thomaswach7/KOP/Teil_B/Frage_01_Rillenkugellager_2Z.md

# Projekt Fliehkraftkupplung – Teil B, Frage 1

> **Aufgabe:** Die Rillenkugellagerbezeichnung beinhaltet das Nachsetzzeichen 2Z.
> Erklären Sie diese Angabe und begründen Sie, warum diese Lagerausführung gewählt wurde.

## 1 Bedeutung der Bezeichnung `DIN 625 – 6009 – 2Z` (Pos. 11)

| Teil der Bezeichnung | Bedeutung |
|---|---|
| **DIN 625** | Norm für einreihige Rillenkugellager |
| **6** | Lagerart: Rillenkugellager, einreihig |
| **0** | Durchmesserreihe 0 (Breitenreihe 1 wird weggelassen → Maßreihe 10, sehr leichte Baureihe) |
| **09** | Bohrungskennzahl: d = 09 · 5 = **45 mm** (gilt ab Kennzahl 04) |
| **2Z** | Nachsetzzeichen: **beidseitig je eine Deckscheibe (Z)** |

Hauptmaße 6009 (Tabellenbuch): **d = 45 mm, D = 75 mm, B = 16 mm** – passend zu den
Lagersitzen Ø45 k6 (Antriebsnabe Pos. 1) und Ø75 H7 (Abtriebsnabe Pos. 2 / Deckel Pos. 4).

**Deckscheibe „Z“:**
- dünne Scheibe aus Stahlblech, im Außenring eingepresst bzw. eingerollt
- **berührungsfrei:** Zum Innenring bleibt ein schmaler Spalt (Spaltdichtung) – es schleift nichts
- „Z“ = Deckscheibe auf **einer** Seite, **„2Z“ = Deckscheiben auf beiden Seiten**
- Das Lager wird vom Hersteller mit Fett gefüllt geliefert → **Lebensdauerschmierung**, nicht nachschmierbar

Abgrenzung: **RS / 2RS** = schleifende Dichtscheiben aus Elastomer (dichter, aber mehr Reibung,
niedrigere Grenzdrehzahl und temperaturempfindlicher).

## 2 Begründung der Lagerwahl

1. **Kein Fett auf die Reibflächen (wichtigster Grund)**
   Die Lager sitzen direkt neben dem Kupplungsraum mit den Reibbelägen (Pos. 5.2) und der
   Reibfläche des Gehäuses (Pos. 3). Austretendes Fett würde die Reibungszahl μ stark senken →
   Kupplung rutscht, das übertragbare Reibmoment M_R = μ · F_N · r_R bricht ein.
   Die Deckscheiben halten das Fett im Lager.

2. **Schutz vor Belagabrieb und Schmutz**
   Beim Anfahren (Schlupfphase) entsteht abrasiver Abrieb der Reibbeläge. Zusätzlich ist die
   Umgebung eines Betonmischers sehr staubig (Zement, Sand). Die Deckscheiben verhindern, dass
   diese Partikel in die Laufbahnen gelangen. Nach außen dichtet zusätzlich der Filzring (Pos. 12) ab.

3. **Wartungsfrei / Lebensdauerschmierung**
   Die Konstruktion hat weder Schmiernippel noch Schmierbohrungen – die Lager sind nach der Montage
   nicht mehr zugänglich. Eine Fettfüllung „auf Lebensdauer“ ist daher notwendig.
   Das ist hier auch ausreichend, weil sich Innen- und Außenring **nur während des Anlaufs**
   (Kupplung offen bzw. schlupfend) relativ zueinander drehen. Ist die Kupplung geschlossen,
   laufen Antriebsnabe und Gehäuse/Abtriebsnabe synchron → keine Relativbewegung im Lager.

4. **Berührungsfrei → geringe Reibung und Erwärmung**
   Z-Deckscheiben schleifen nicht: kein zusätzliches Reibmoment, keine Zusatzwärme, hohe
   Grenzdrehzahl (bei n = 1450 min⁻¹ unkritisch). Da beim Rutschen ohnehin Reibwärme im Gehäuse
   entsteht, sind **Stahlblech-Deckscheiben temperaturbeständiger** als Elastomer-Dichtungen (RS).

5. **Kompakt, kostengünstig, Normteil**
   Die Abdichtung ist im Lager integriert (gleiche Breite B = 16 mm wie offene Ausführung) –
   es werden keine zusätzlichen Dichtelemente im beengten Bauraum zwischen Nabe und Deckel benötigt.
   Das Lager ist ein günstiges Katalog-/Normteil.

## Kurzantwort (für das Antwortdokument)

> **2Z** bedeutet, dass das Rillenkugellager 6009 (d = 45 mm, D = 75 mm, B = 16 mm) **auf beiden
> Seiten eine berührungsfreie Deckscheibe aus Stahlblech** besitzt. Das Lager ist ab Werk mit Fett
> gefüllt und **lebensdauergeschmiert**.
> Gewählt wurde diese Ausführung, weil **kein Schmierfett auf die Reibbeläge bzw. die Reibfläche des
> Gehäuses gelangen darf** (sonst sinkt μ und die Kupplung rutscht), weil das Lager vor **Belagabrieb und
> Staub** geschützt werden muss und weil die Lager nach der Montage **nicht nachgeschmiert** werden
> können. Da sich die Lagerringe nur beim Anlauf relativ zueinander drehen, reicht die Fettfüllung für
> die gesamte Lebensdauer. Die berührungsfreie Z-Abdichtung verursacht zudem keine Zusatzreibung und
> ist unempfindlich gegen die beim Rutschen entstehende Wärme.
