thomaswach7/KOP/Portrait_CAD/vorschau_linien.png

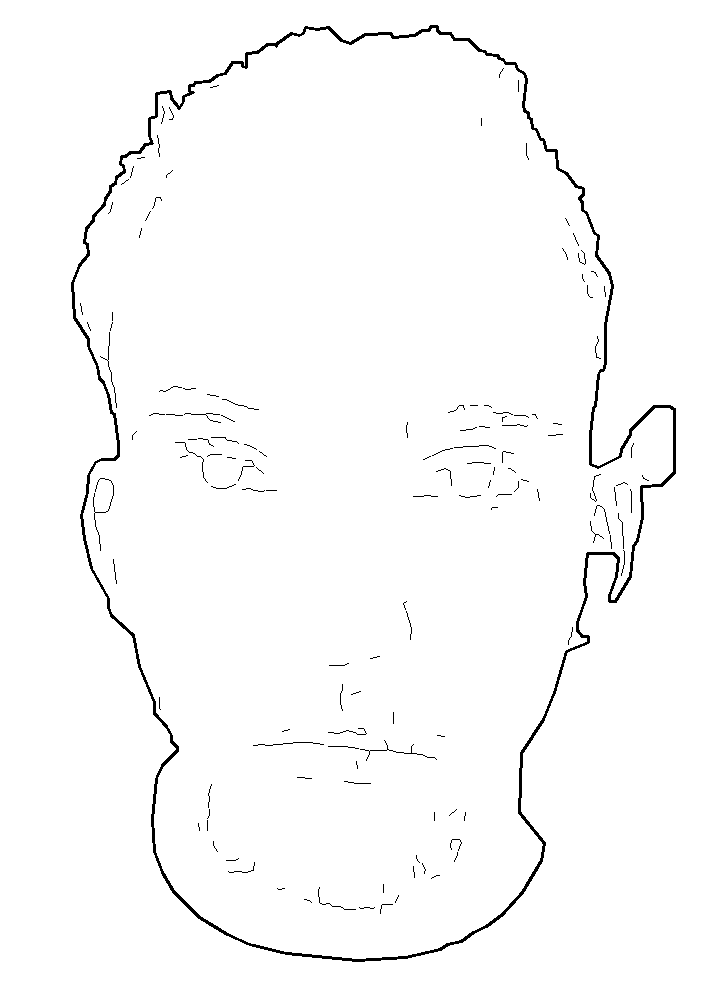
Portrait_CAD/vorschau_linien.png
