thomaswach7/KOP/Portrait_CAD/vorschau_relief.png

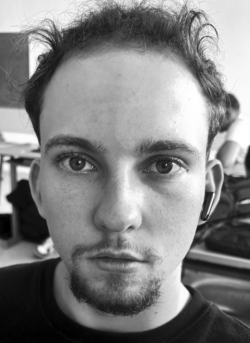
Portrait_CAD/vorschau_relief.png
