thomaswach7/KOP/Skulptur_3D/vorschau_8_ansichten.png

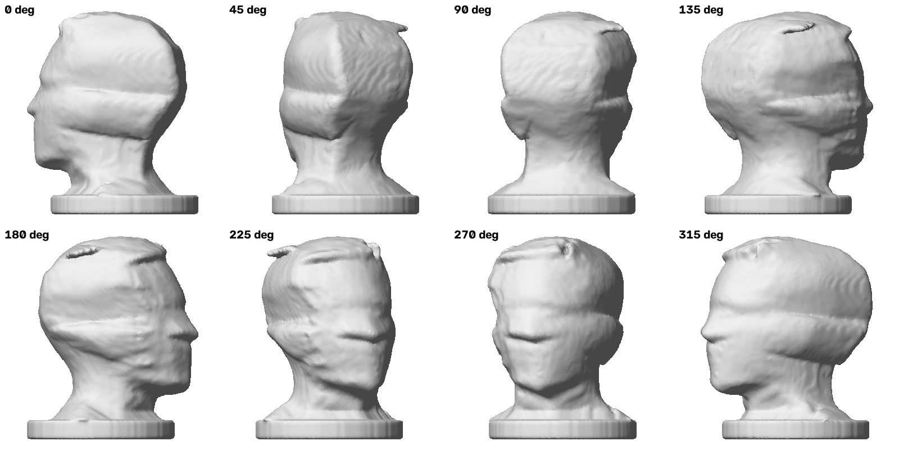
Skulptur_3D/vorschau_8_ansichten.png
