thomaswach7/KOP/Teil_A/Gesamtzeichnung_Vorschau.png

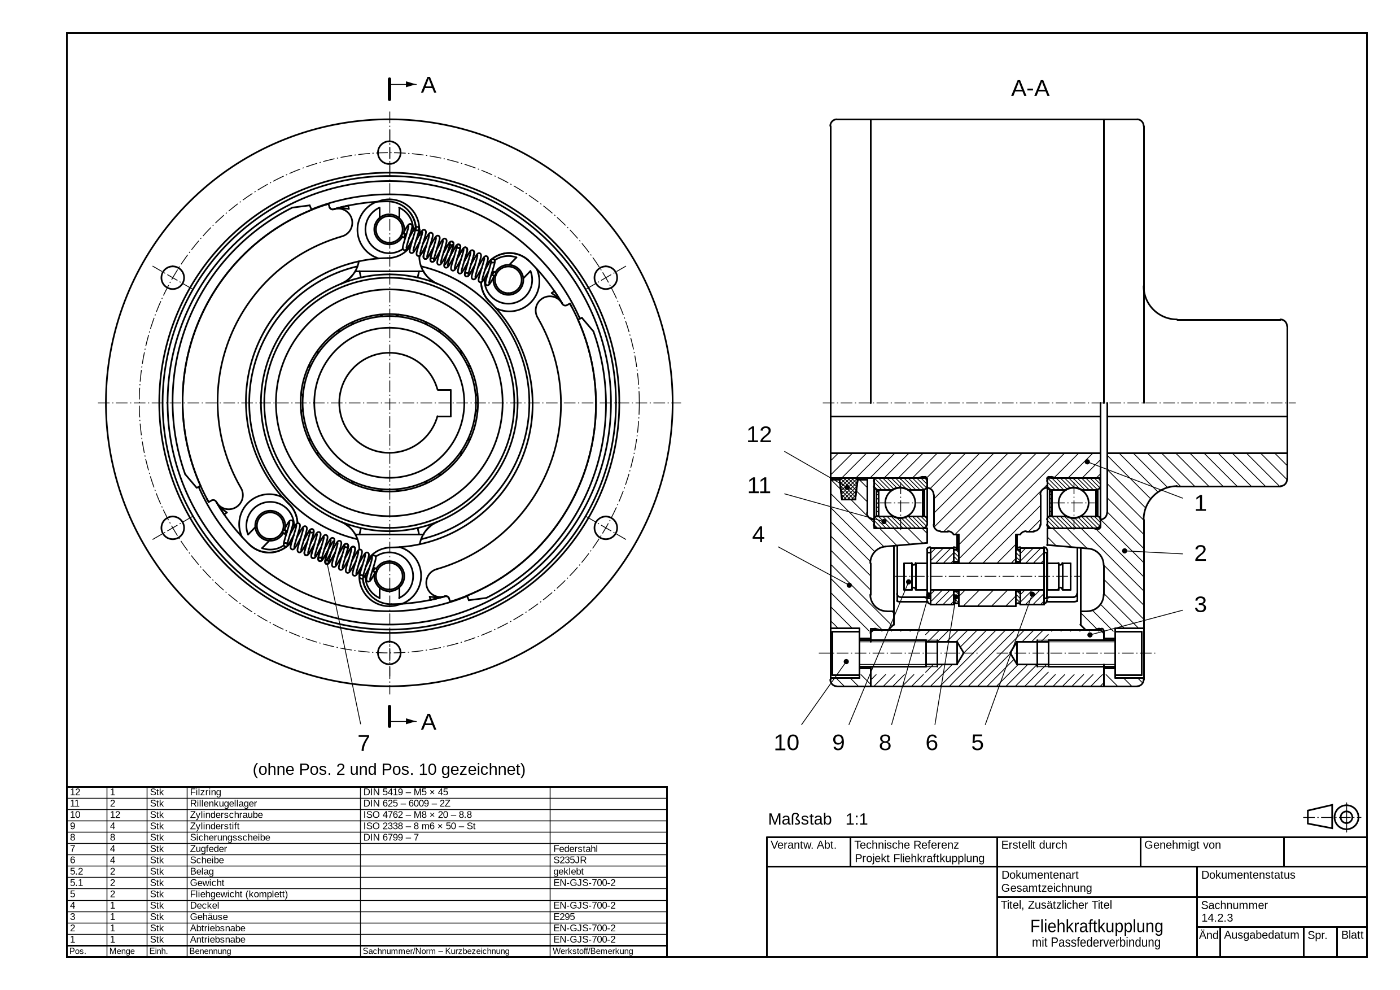
Teil_A/Gesamtzeichnung_Vorschau.png
