thomaswach7/KOP/Teil_A/CAD/Baugruppe_Fliehkraftkupplung_komplett.step

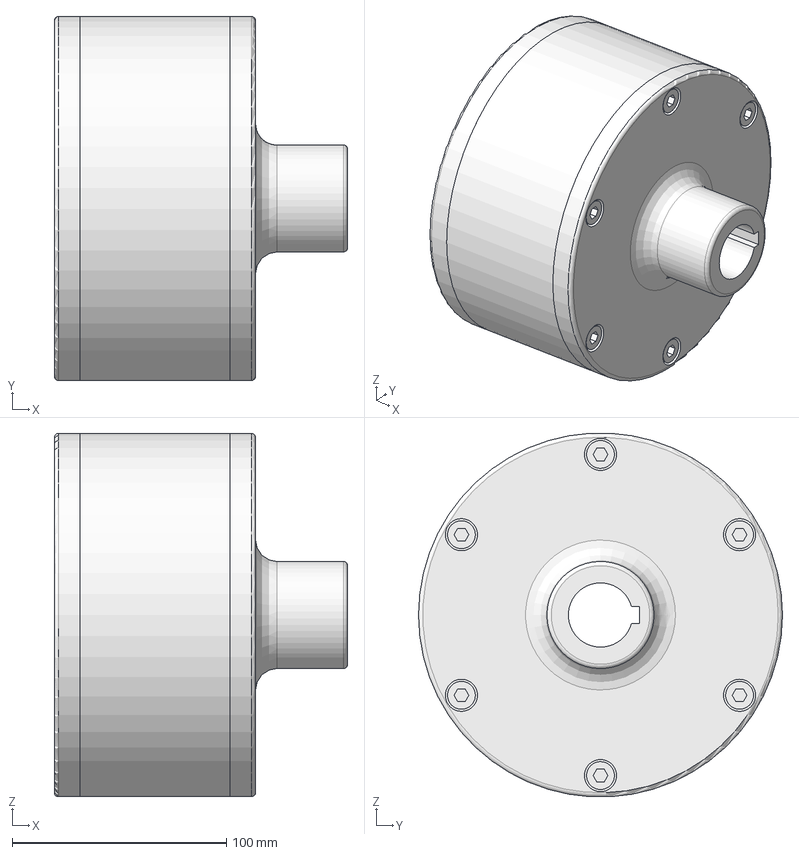
[picture p62: CAD file, 2026-10-28]
Teil_A/CAD/Baugruppe_Fliehkraftkupplung_komplett.step
137.0 x 170.0 x 169.7 mm
Pos1_Antriebsnabe
Pos2_Abtriebsnabe
Pos3_Gehaeuse
Pos4_Deckel
Pos5.1_Gewicht_1
Pos5.2_Belag_1
Pos5.1_Gewicht_2
Pos5.2_Belag_2
Pos6_Scheibe_1
Pos6_Scheibe_2
Pos6_Scheibe_3
Pos6_Scheibe_4
Pos7_Zugfeder_1
Pos7_Zugfeder_2
Pos7_Zugfeder_3
Pos7_Zugfeder_4
Pos8_Sicherungsscheibe_1
Pos8_Sicherungsscheibe_2
Pos8_Sicherungsscheibe_3
Pos8_Sicherungsscheibe_4
Pos8_Sicherungsscheibe_5
Pos8_Sicherungsscheibe_6
Pos8_Sicherungsscheibe_7
Pos8_Sicherungsscheibe_8
Pos9_Zylinderstift_1
Pos9_Zylinderstift_2
Pos9_Zylinderstift_3
Pos9_Zylinderstift_4
Pos10_Zylinderschraube_1
Pos10_Zylinderschraube_2
Pos10_Zylinderschraube_3
Pos10_Zylinderschraube_4
Pos10_Zylinderschraube_5
Pos10_Zylinderschraube_6
Pos10_Zylinderschraube_7
Pos10_Zylinderschraube_8
Pos10_Zylinderschraube_9
Pos10_Zylinderschraube_10
Pos10_Zylinderschraube_11
Pos10_Zylinderschraube_12
Pos11_Rillenkugellager_1
Pos11_Rillenkugellager_2
Pos12_Filzring
