thomaswach7/KOP/Portrait_CAD/portrait_relief.stl

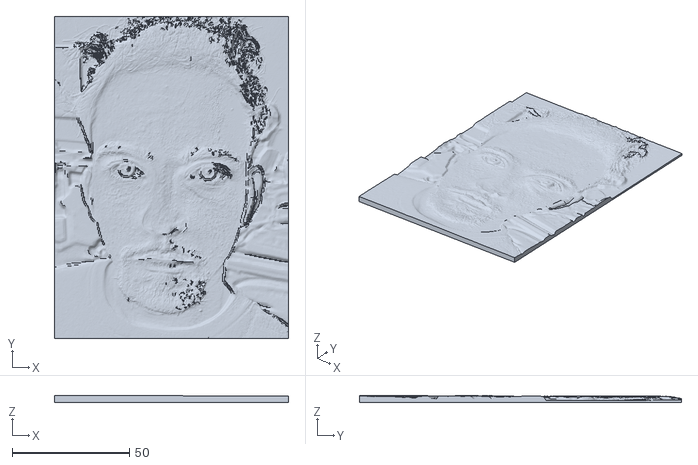
[picture p63: CAD file, 2026-10-09]
Portrait_CAD/portrait_relief.stl
100.0 x 137.6 x 3.00
