thomaswach7/KOP/Skulptur_3D/kopf_skulptur.stl

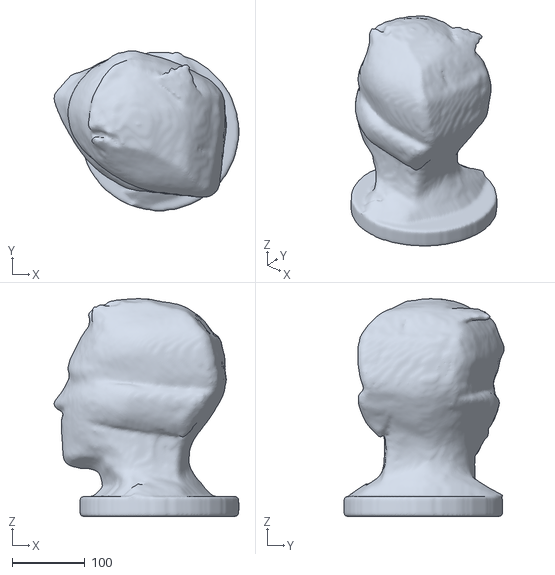
[picture p64: CAD file, 2026-10-09]
Skulptur_3D/kopf_skulptur.stl
253.5 x 219.9 x 299.4
