thomaswach7/KOP/Teil_A/CAD/Einzelteile_alle/Pos11_Rillenkugellager_6009-2Z.stp

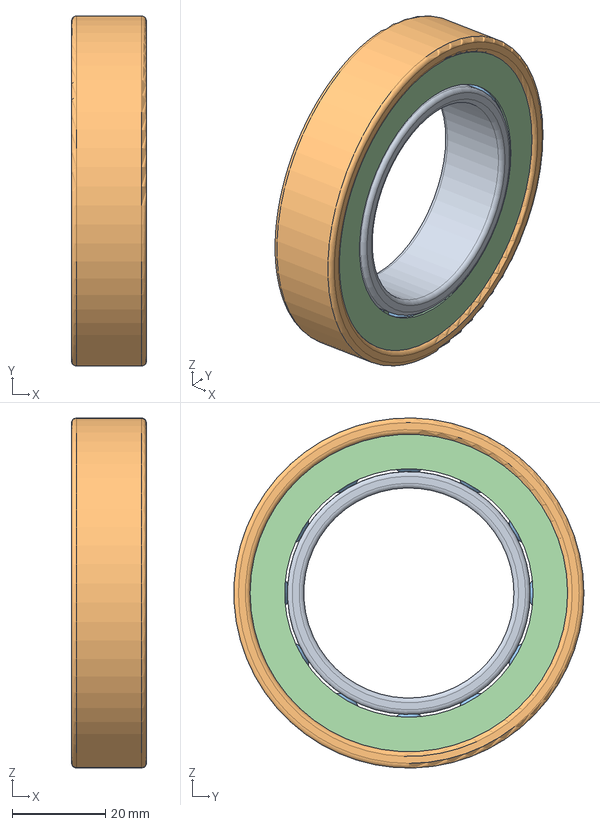
[picture p65: CAD file, 2026-10-28]
Teil_A/CAD/Einzelteile_alle/Pos11_Rillenkugellager_6009-2Z.stp
16.0 x 74.9 x 75.0 mm
