thomaswach7/KOP/Teil_A/Gesamtzeichnung_Fliehkraftkupplung_wie_Vorlage.dxf

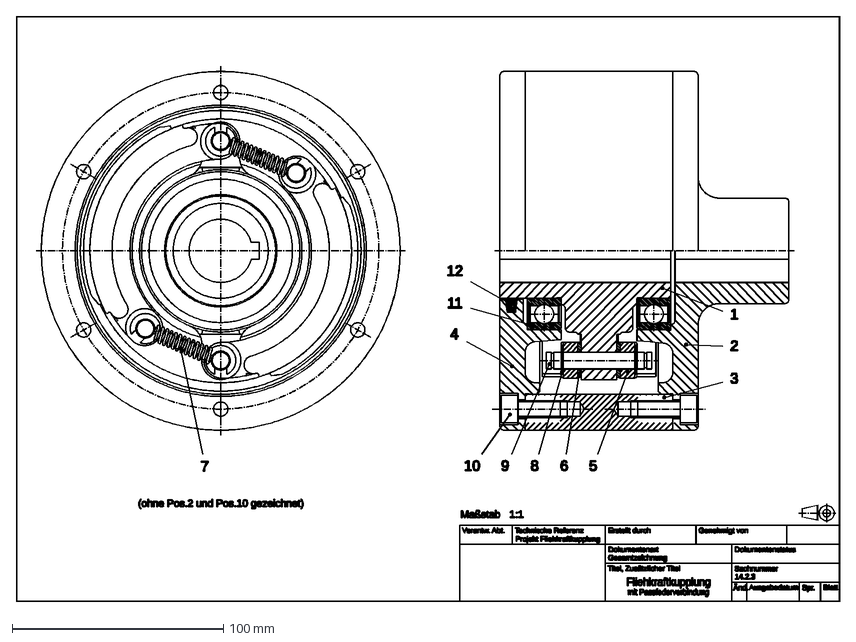
[picture p66: CAD file, 2026-10-28]
Teil_A/Gesamtzeichnung_Fliehkraftkupplung_wie_Vorlage.dxf
390.5 x 277.5 mm
