thomaswach7/KOP/Teil_D/Modellbaum/CAD_Kontrollmodelle/Pos07_Zugfeder_ungespannt.step

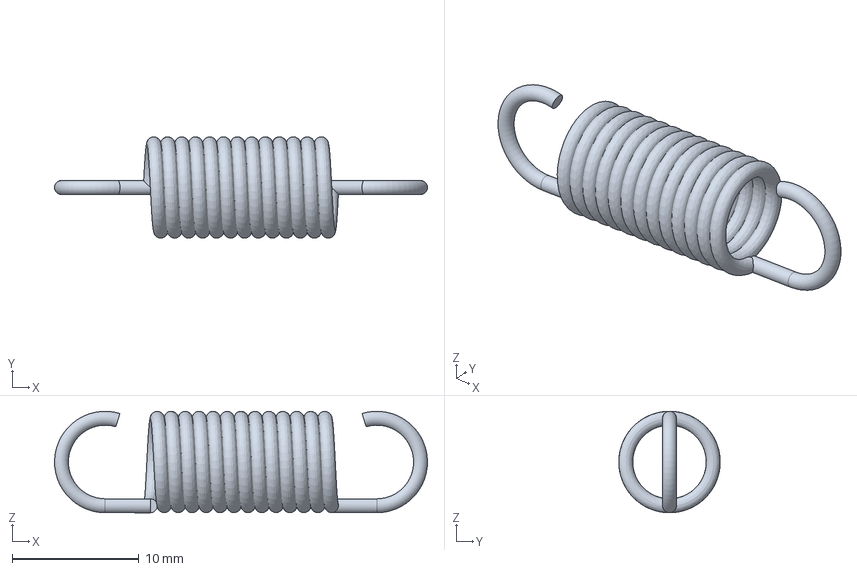
[picture p67: CAD file, 2026-10-12]
Teil_D/Modellbaum/CAD_Kontrollmodelle/Pos07_Zugfeder_ungespannt.step
29.4 x 8.00 x 8.00 mm
