thomaswach7/KOP/Teil_D/Pos02_Abtriebsnabe.dxf

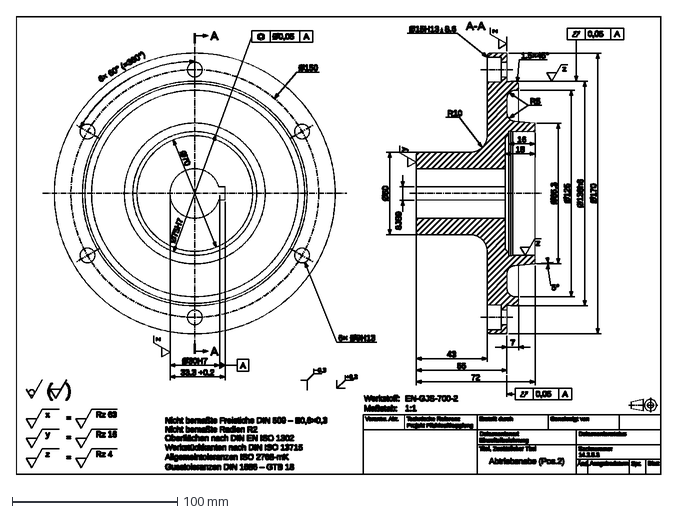
[picture p68: CAD file, 2026-11-06]
Teil_D/Pos02_Abtriebsnabe.dxf
390.5 x 277.5 mm
