thomaswach7/KOP/Portrait_CAD/portrait_linien.dxf

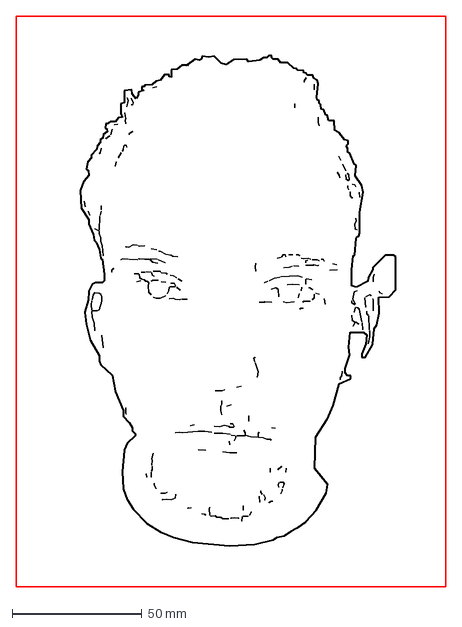
[picture p69: CAD file, 2026-10-09]
Portrait_CAD/portrait_linien.dxf
165.4 x 220.0 mm
