thomaswach7/KOP/Teil_A/CAD/Einzelteile_alle/Pos05-2_Belag.stp

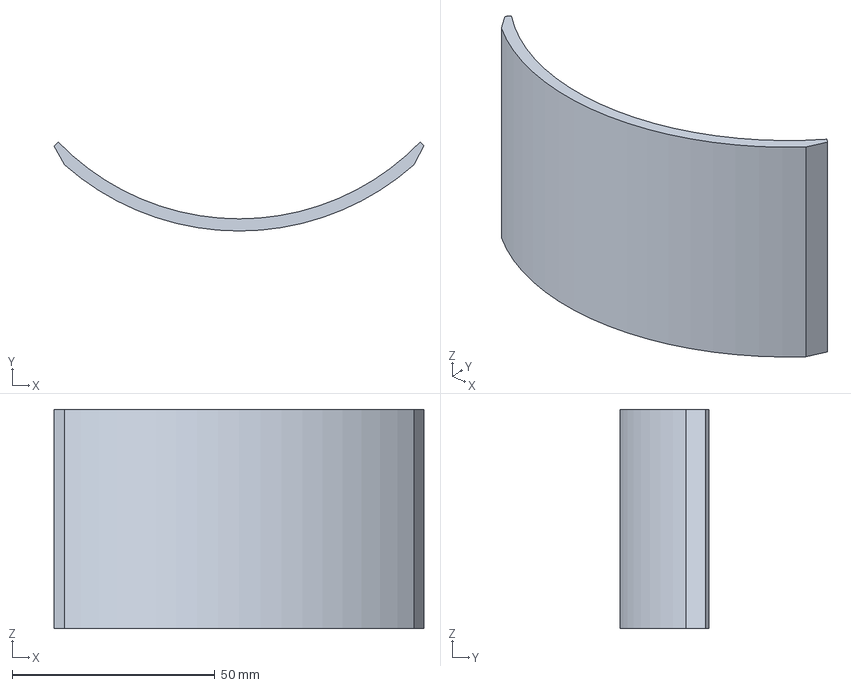
[picture p70: CAD file, 2026-10-05]
Teil_A/CAD/Einzelteile_alle/Pos05-2_Belag.stp
91.2 x 21.9 x 54.0 mm
