thomaswach7/KOP/Teil_A/Gesamtzeichnung_Fliehkraftkupplung.dxf

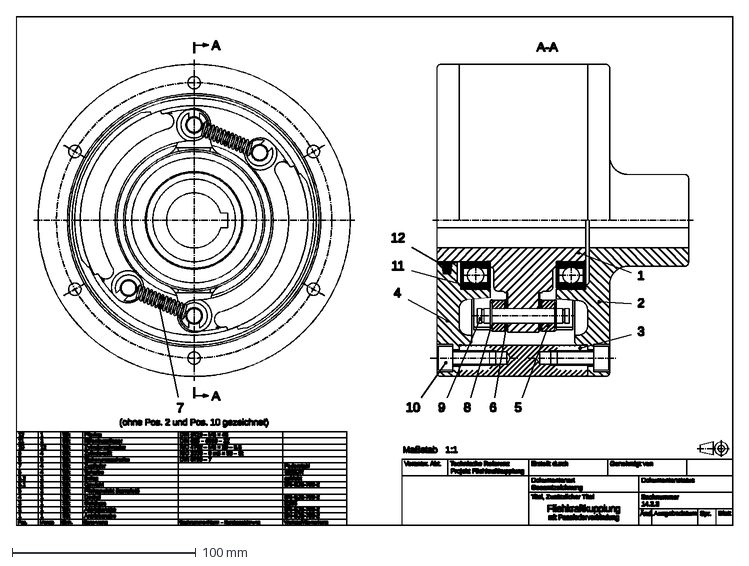
[picture p71: CAD file, 2026-10-28]
Teil_A/Gesamtzeichnung_Fliehkraftkupplung.dxf
390.5 x 277.5 mm
