thomaswach7/KOP/Teil_D/Modellbaum/CAD_Kontrollmodelle/Pos12_Filzring.step

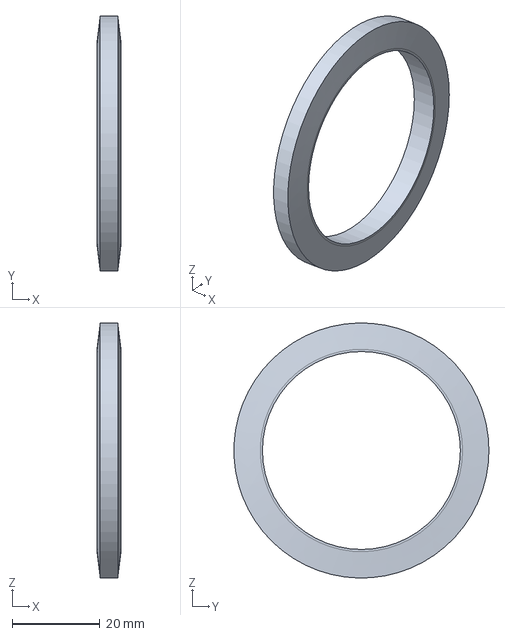
[picture p72: CAD file, 2026-10-05]
Teil_D/Modellbaum/CAD_Kontrollmodelle/Pos12_Filzring.step
5.48 x 58.0 x 58.0 mm
