thomaswach7/KOP/Teil_D/Pos01_Antriebsnabe.dxf

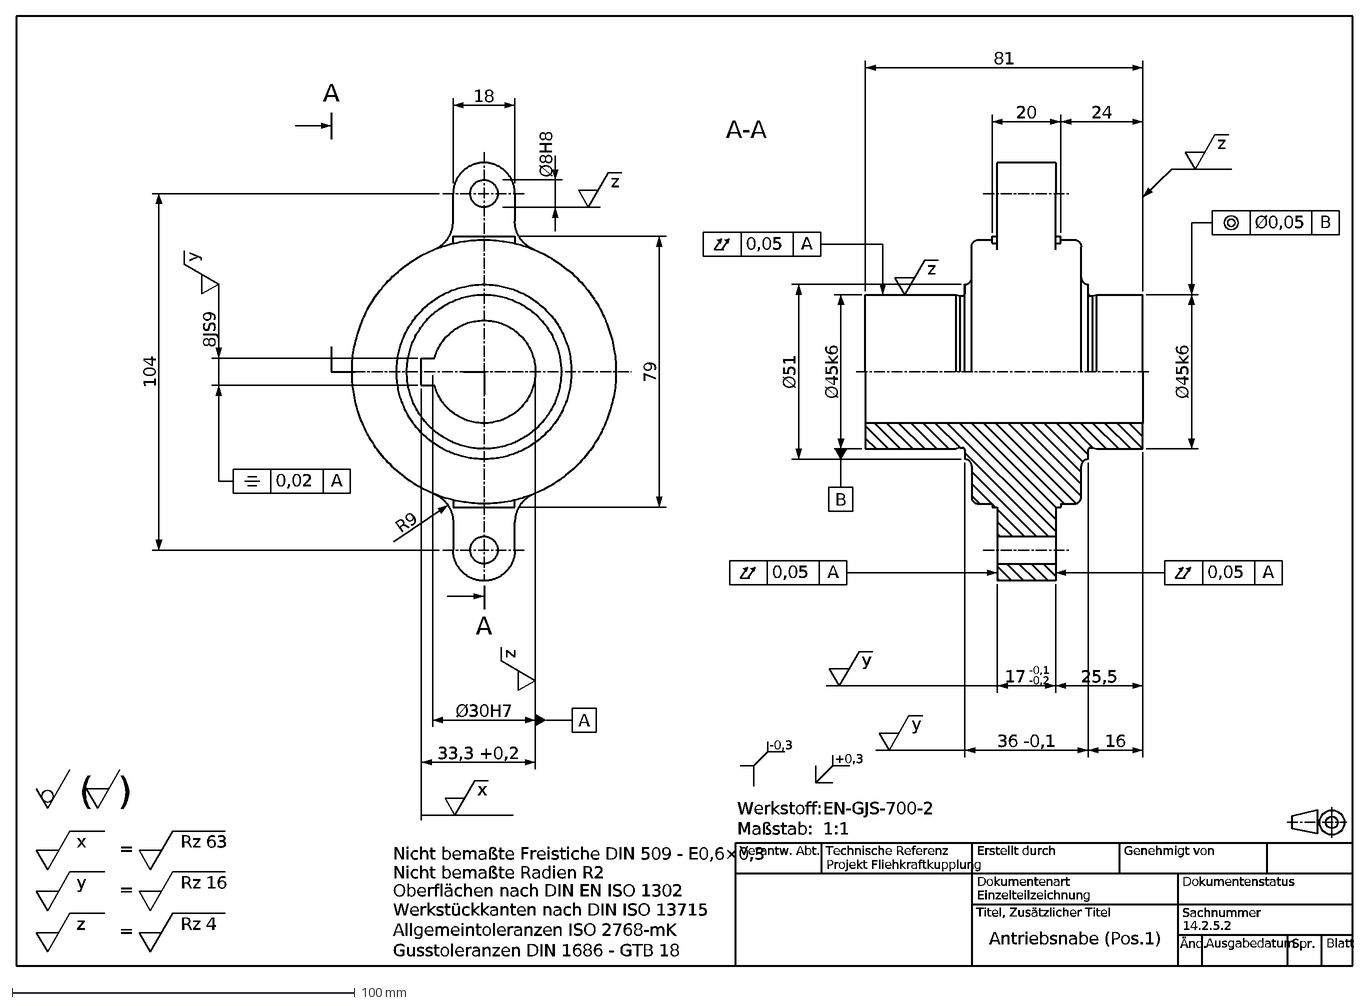
[picture p73: CAD file, 2026-10-09]
Teil_D/Pos01_Antriebsnabe.dxf
A
A-A
18
Ø8H8
z
104
8JS9
y
0,02
79
R9
Ø30H7
33,3 +0,2
x
81
20
24
0,05
Ø51
Ø45k6
B
Ø0,05
17
-0,1
-0,2
25,5
36 -0,1
16
(
)
=
Rz 63
Rz 16
Rz 4
-0,3
+0,3
Nicht bemaßte Freistiche DIN 509 - E0,6×0,3
Nicht bemaßte Radien R2
Oberflächen nach DIN EN ISO 1302
Werkstückkanten nach DIN ISO 13715
Allgemeintoleranzen ISO 2768-mK
Gusstoleranzen DIN 1686 - GTB 18
Verantw. Abt.
Technische Referenz
Projekt Fliehkraftkupplung
Erstellt durch
Genehmigt von
Dokumentenart
Einzelteilzeichnung
Titel, Zusätzlicher Titel
Antriebsnabe (Pos.1)
Dokumentenstatus
Sachnummer
14.2.5.2
Änd.
Ausgabedatum
Spr.
Blatt
Werkstoff:
EN-GJS-700-2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
