thomaswach7/KOP/Teil_A/CAD/Einzelteile_alle/Pos05-1_Gewicht.stp

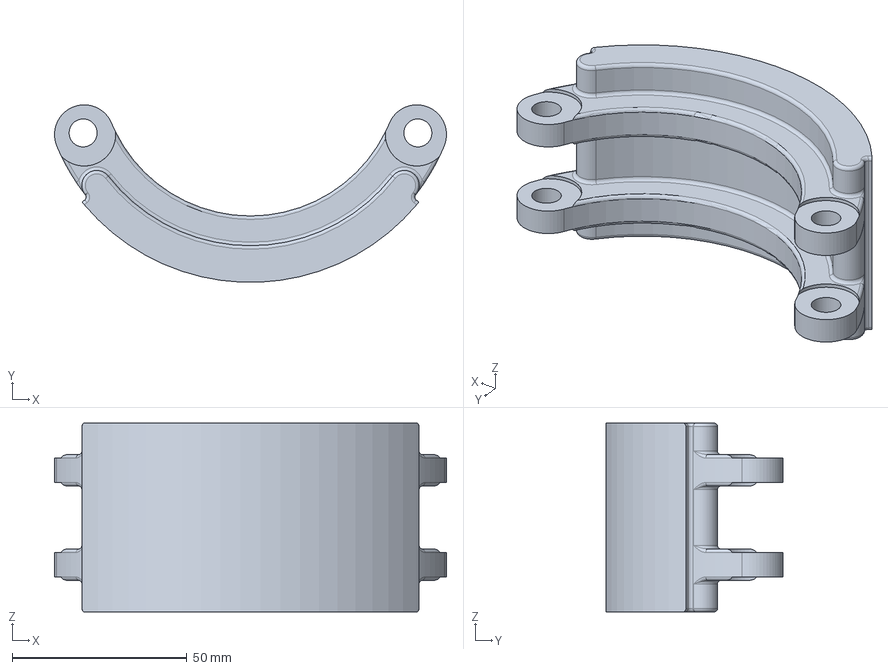
[picture p74: CAD file, 2026-10-05]
Teil_A/CAD/Einzelteile_alle/Pos05-1_Gewicht.stp
112.2 x 50.7 x 54.0 mm
