thomaswach7/KOP/Teil_D/Modellbaum/CAD_Kontrollmodelle/Pos04_Deckel.step

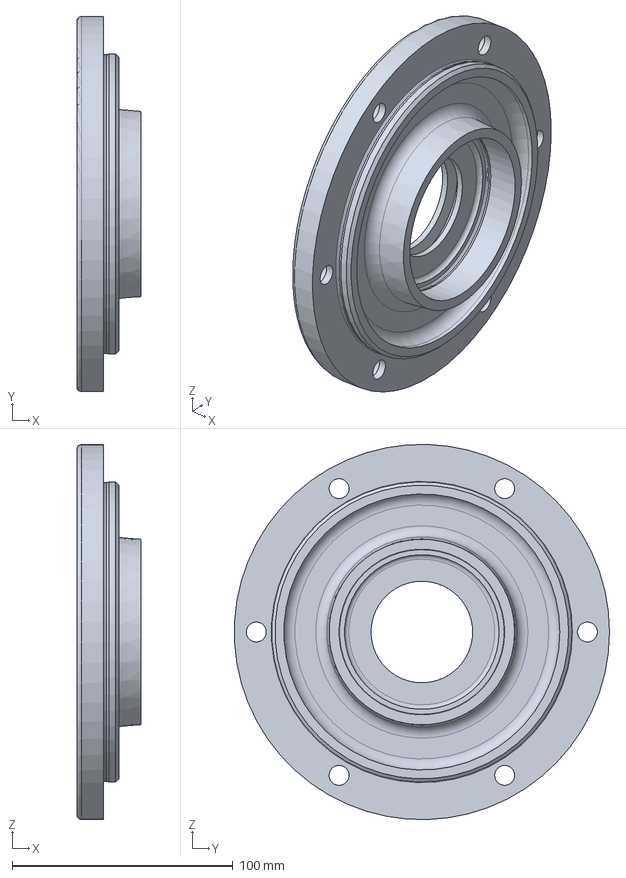
[picture p75: CAD file, 2026-10-05]
Teil_D/Modellbaum/CAD_Kontrollmodelle/Pos04_Deckel.step
29.0 x 169.9 x 169.9 mm
