thomaswach7/KOP/Teil_A/CAD/Einzelteile_alle/Pos01_Antriebsnabe.stp

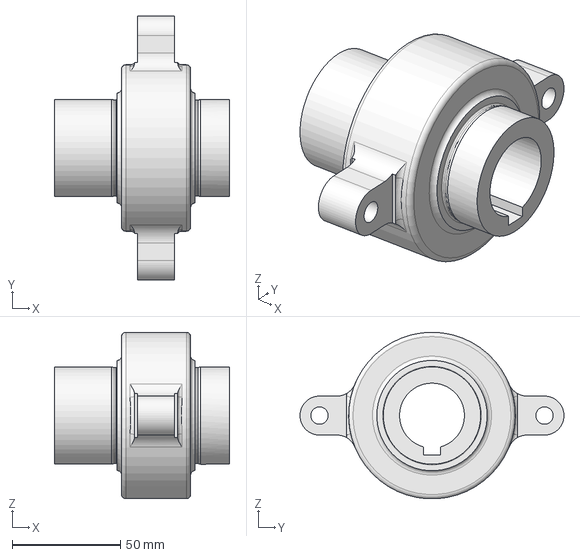
[picture p76: CAD file, 2026-10-05]
Teil_A/CAD/Einzelteile_alle/Pos01_Antriebsnabe.stp
81.0 x 122.0 x 76.9 mm
