thomaswach7/KOP/Teil_D/Modellbaum/CAD_Kontrollmodelle/Pos09_Zylinderstift.step

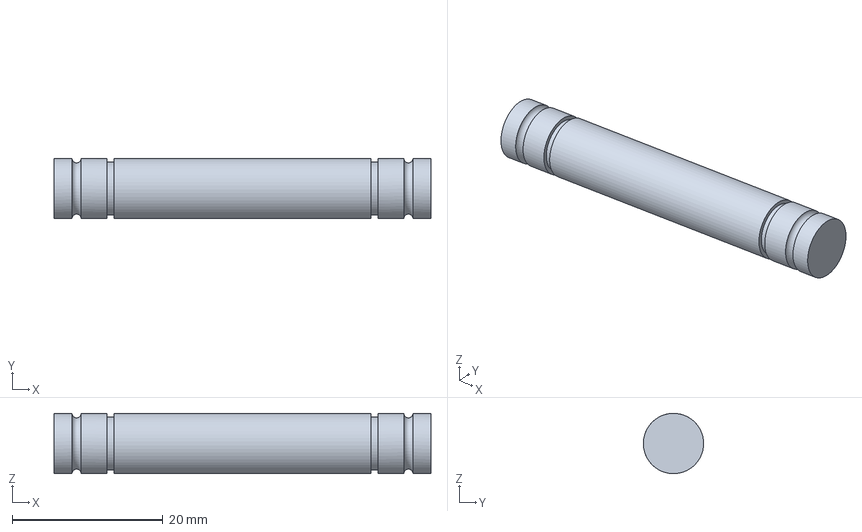
[picture p77: CAD file, 2026-10-05]
Teil_D/Modellbaum/CAD_Kontrollmodelle/Pos09_Zylinderstift.step
50.0 x 8.00 x 8.00 mm
