thomaswach7/KOP/Teil_A/CAD/Einzelteile_alle/Pos07_Zugfeder_ungespannt.stp

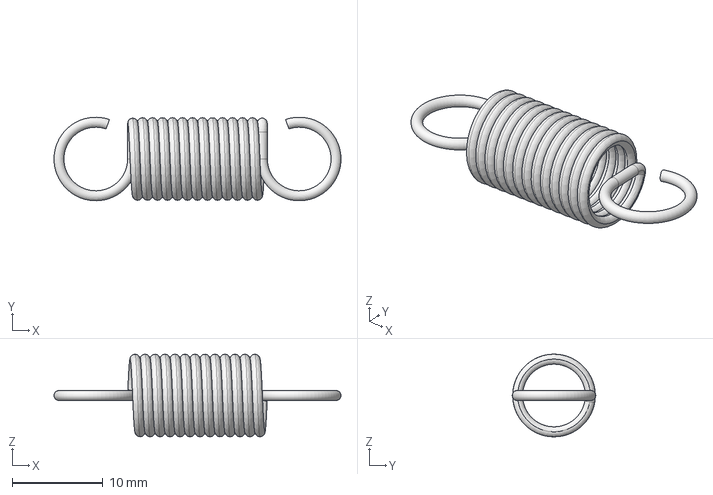
[picture p78: CAD file, 2026-10-05]
Teil_A/CAD/Einzelteile_alle/Pos07_Zugfeder_ungespannt.stp
31.6 x 9.19 x 9.10 mm
