thomaswach7/KOP/Teil_D/Modellbaum/CAD_Kontrollmodelle/Pos05-1_Gewicht.step

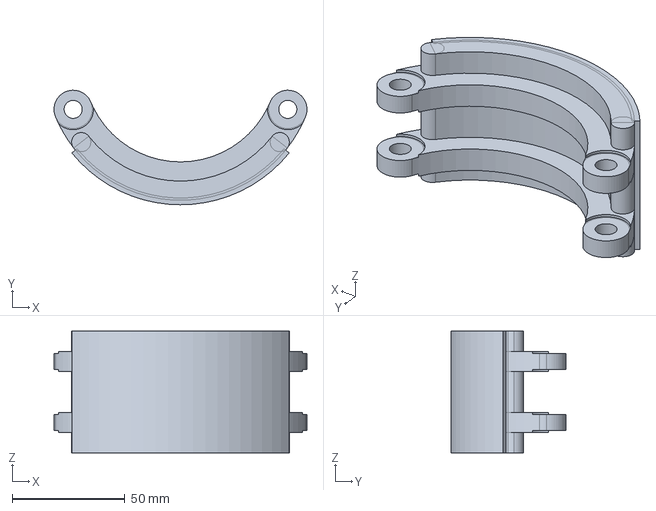
[picture p79: CAD file, 2026-10-05]
Teil_D/Modellbaum/CAD_Kontrollmodelle/Pos05-1_Gewicht.step
112.2 x 50.8 x 54.0 mm
