thomaswach7/KOP/Teil_A/CAD/Einzelteile_alle/Pos05_Fliehgewicht_komplett.stp

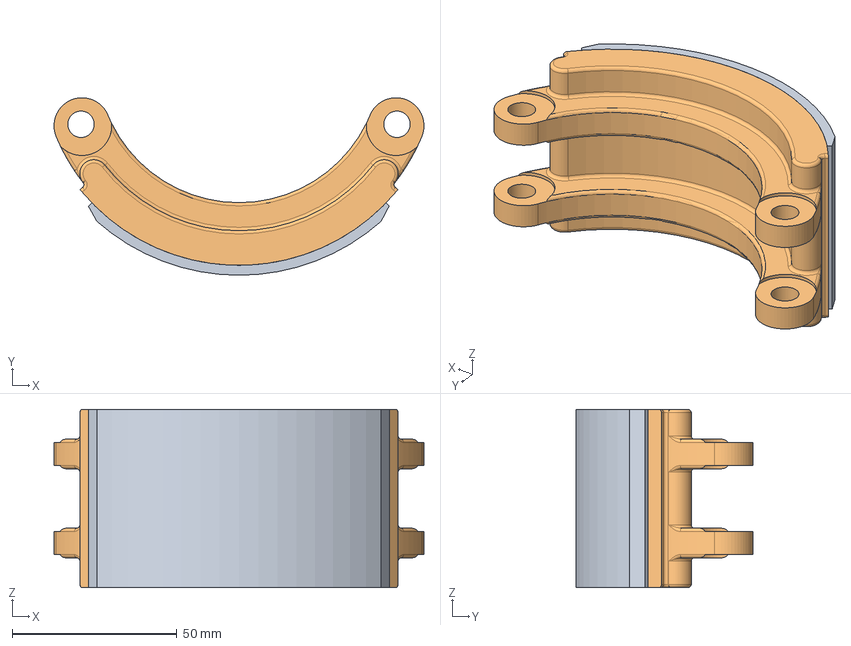
[picture p80: CAD file, 2026-10-05]
Teil_A/CAD/Einzelteile_alle/Pos05_Fliehgewicht_komplett.stp
112.2 x 53.8 x 54.0 mm
Pos5_2_Belag
Pos5_1_Gewicht
