thomaswach7/KOP/Teil_A/CAD/Einzelteile_alle/Pos02_Abtriebsnabe.stp

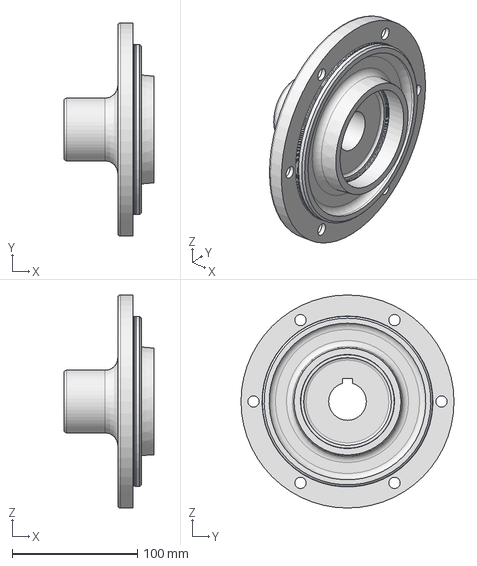
[picture p81: CAD file, 2026-10-05]
Teil_A/CAD/Einzelteile_alle/Pos02_Abtriebsnabe.stp
72.0 x 170.0 x 170.0 mm
