thomaswach7/KOP/Teil_D/Modellbaum/CAD_Kontrollmodelle/Pos01_Antriebsnabe.step

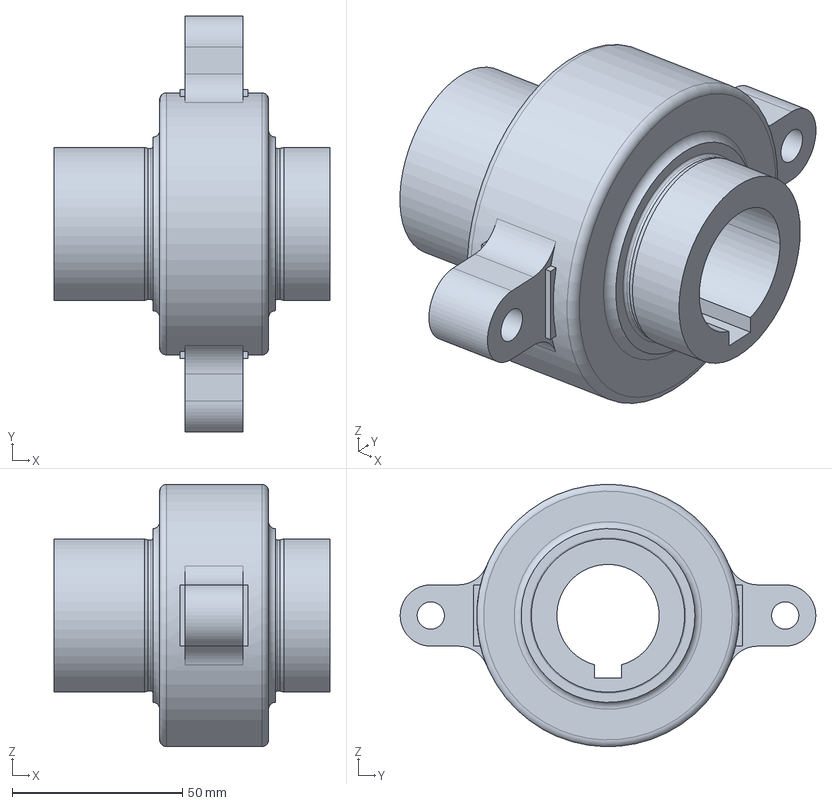
[picture p82: CAD file, 2026-10-05]
Teil_D/Modellbaum/CAD_Kontrollmodelle/Pos01_Antriebsnabe.step
81.0 x 122.0 x 77.0 mm
