thomaswach7/KOP/Teil_D/Modellbaum/CAD_Kontrollmodelle/Pos03_Gehaeuse.step

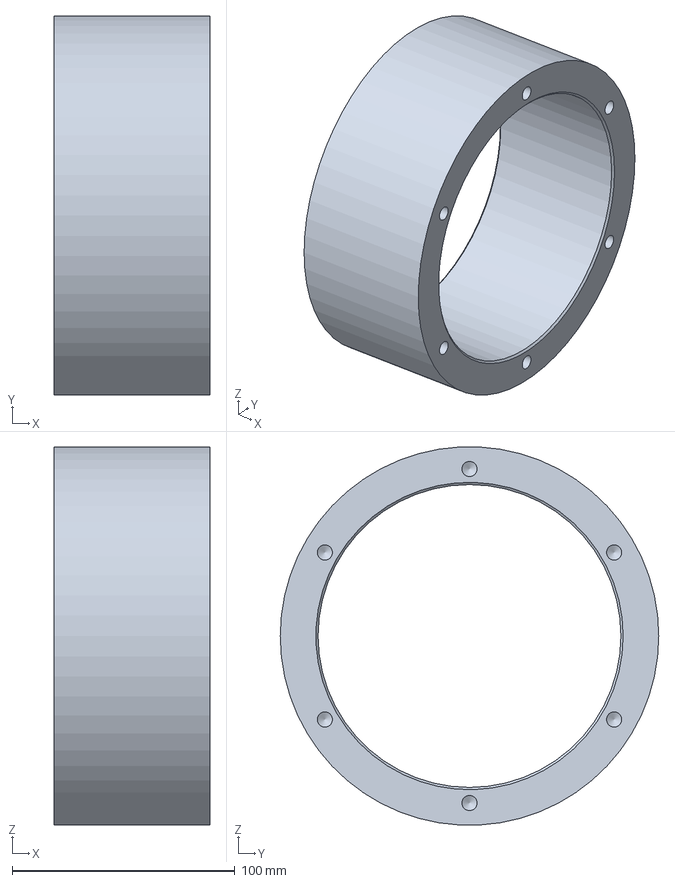
[picture p83: CAD file, 2026-10-05]
Teil_D/Modellbaum/CAD_Kontrollmodelle/Pos03_Gehaeuse.step
70.0 x 170.0 x 169.8 mm
