thomaswach7/KOP/Teil_D/Modellbaum/CAD_Kontrollmodelle/Pos06_Scheibe.step

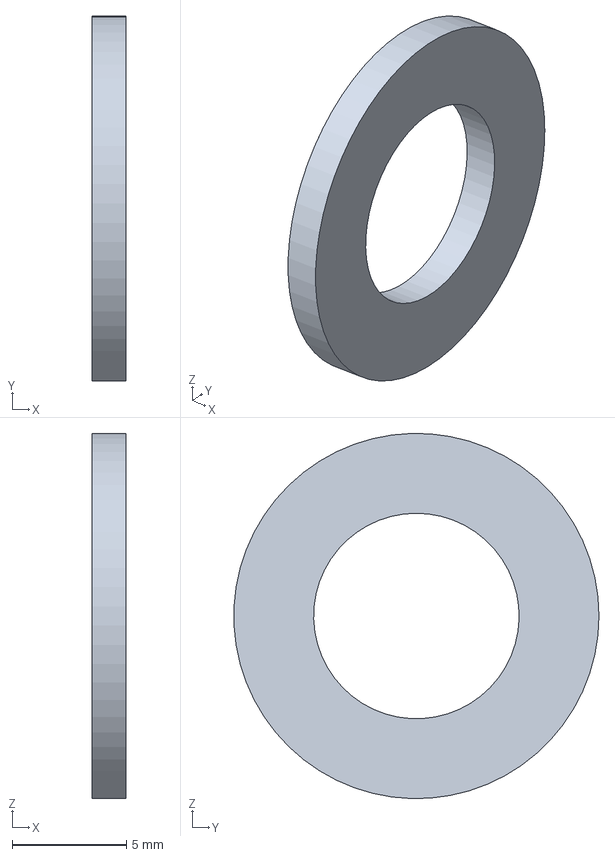
[picture p84: CAD file, 2026-10-05]
Teil_D/Modellbaum/CAD_Kontrollmodelle/Pos06_Scheibe.step
1.50 x 16.0 x 16.0 mm
