thomaswach7/KOP/Teil_A/CAD/Einzelteile_alle/Pos10_Zylinderschraube_M8x20.stp

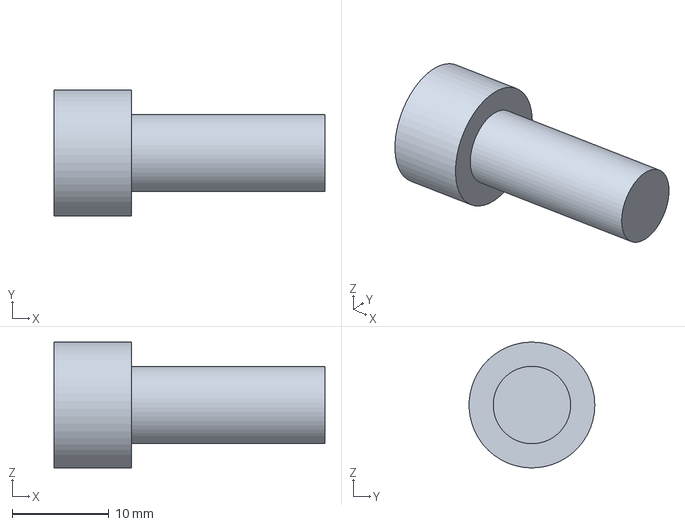
[picture p85: CAD file, 2026-10-05]
Teil_A/CAD/Einzelteile_alle/Pos10_Zylinderschraube_M8x20.stp
28.0 x 13.0 x 13.0 mm
