thomaswach7/KOP/Teil_A/CAD/Einzelteile_alle/Pos12_Filzring.stp

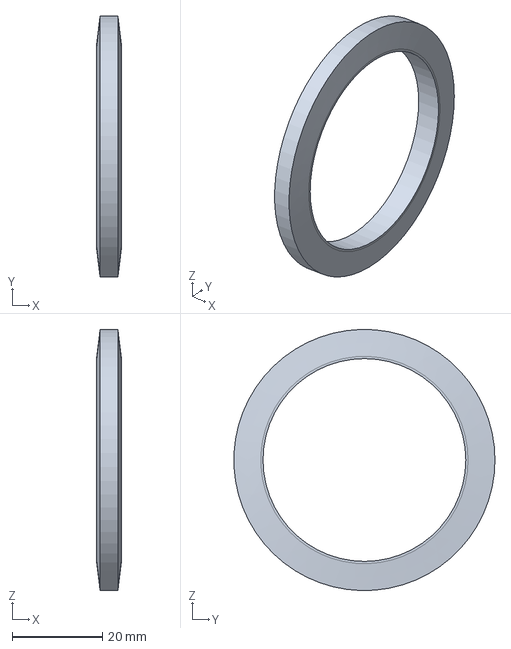
[picture p86: CAD file, 2026-10-05]
Teil_A/CAD/Einzelteile_alle/Pos12_Filzring.stp
5.44 x 57.9 x 57.9 mm
