thomaswach7/KOP/Teil_A/CAD/Einzelteile_alle/Pos07_Zugfeder_gespannt.stp

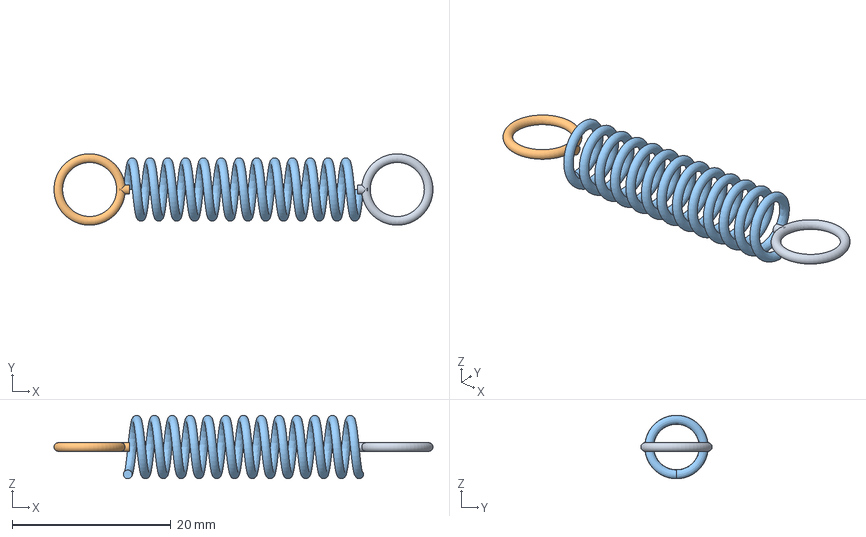
[picture p87: CAD file, 2026-10-02]
Teil_A/CAD/Einzelteile_alle/Pos07_Zugfeder_gespannt.stp
47.8 x 9.00 x 8.00 mm
