thomaswach7/KOP/Teil_A/CAD/Einzelteile_alle/Pos08_Sicherungsscheibe_DIN6799-7.stp

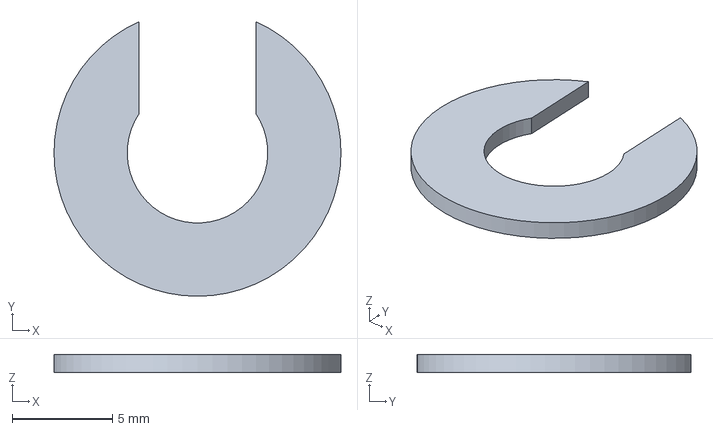
[picture p88: CAD file, 2026-10-02]
Teil_A/CAD/Einzelteile_alle/Pos08_Sicherungsscheibe_DIN6799-7.stp
14.3 x 13.7 x 0.9 mm
