thomaswach7/KOP/(list of files, cad)

Other CAD files:
Teil_A/CAD/Einzelteile_neu/Pos11_Rillenkugellager_6009-2Z_vereinfacht.step
Teil_D/Modellbaum/CAD_Kontrollmodelle/Pos05-2_Belag.step
Teil_A/CAD/Einzelteile_alle/Pos04_Deckel.stp
Teil_A/CAD/Einzelteile_alle/Pos09_Zylinderstift.stp
Teil_D/Modellbaum/CAD_Kontrollmodelle/Pos02_Abtriebsnabe.step
Teil_A/CAD/Einzelteile_alle/Pos03_Gehaeuse.stp
Teil_A/CAD/Einzelteile_alle/Pos06_Scheibe.stp
