thomaswach7/KOP/Teil_D/Einzelteilzeichnungen_alle.pdf

A
A-A

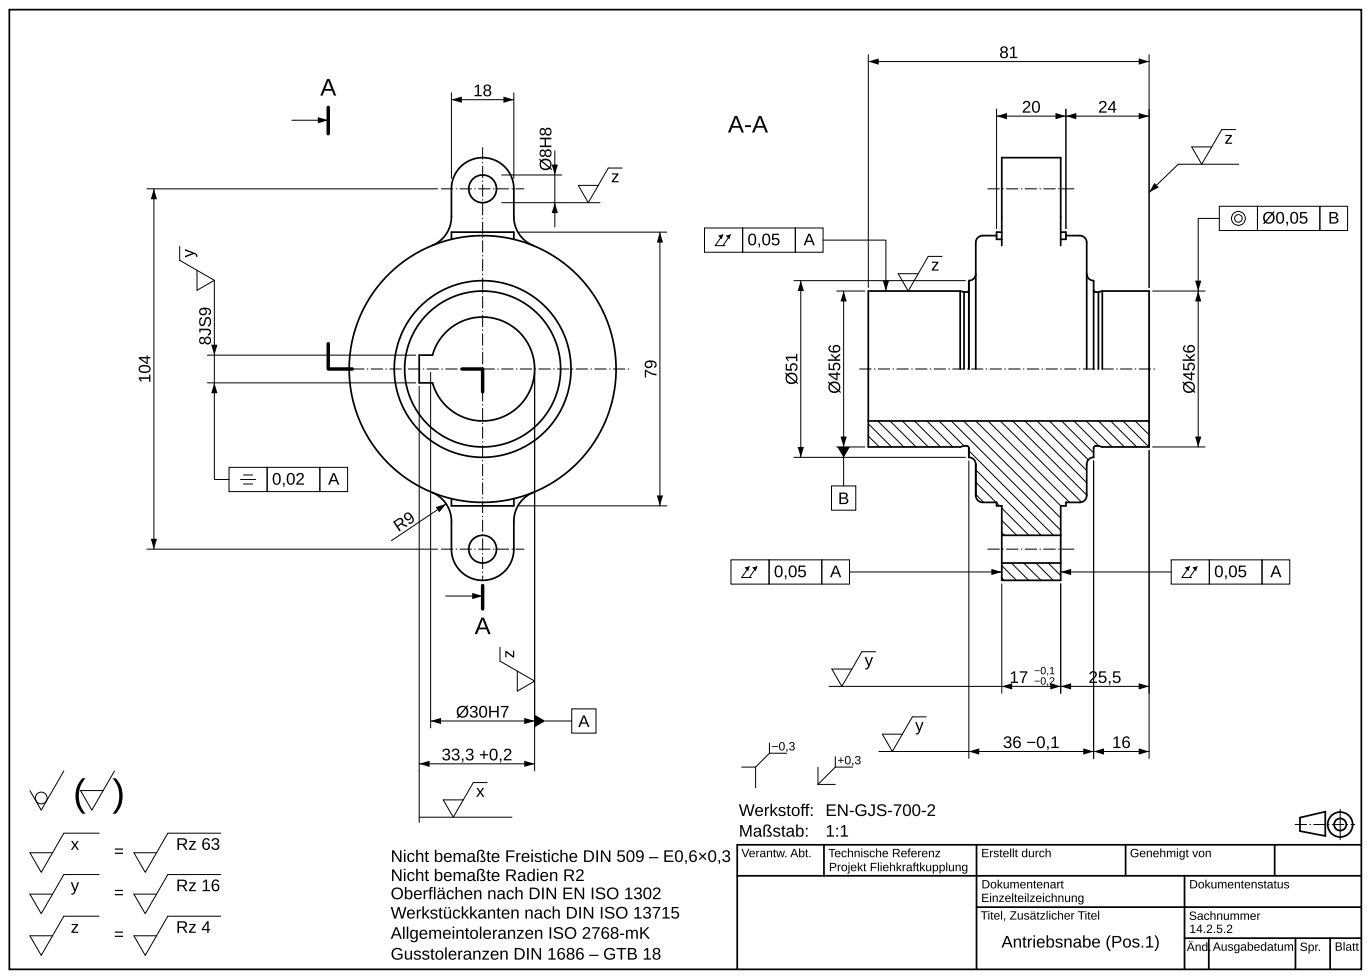
[picture p133: page 1]
Verantw. Abt.; Technische Referenz; Projekt Fliehkraftkupplung; Erstellt durch; Genehmigt von; Dokumentenstatus; Sachnummer 14.2.5.2; Änd.Ausgabedatum; Spr.; Blatt

Werkstoff: EN-GJS-700-2
Maßstab: 1:1

Nicht bemaßte Freistiche DIN 509 – E0,6×0,3
Nicht bemaßte Radien R2
Oberflächen nach DIN EN ISO 1302
Werkstückkanten nach DIN ISO 13715
Allgemeintoleranzen ISO 2768-mK
Gusstoleranzen DIN 1686 – GTB 18

Dokumentenart
Einzelteilzeichnung
Titel, Zusätzlicher Titel
Antriebsnabe (Pos.1)

A

A-A

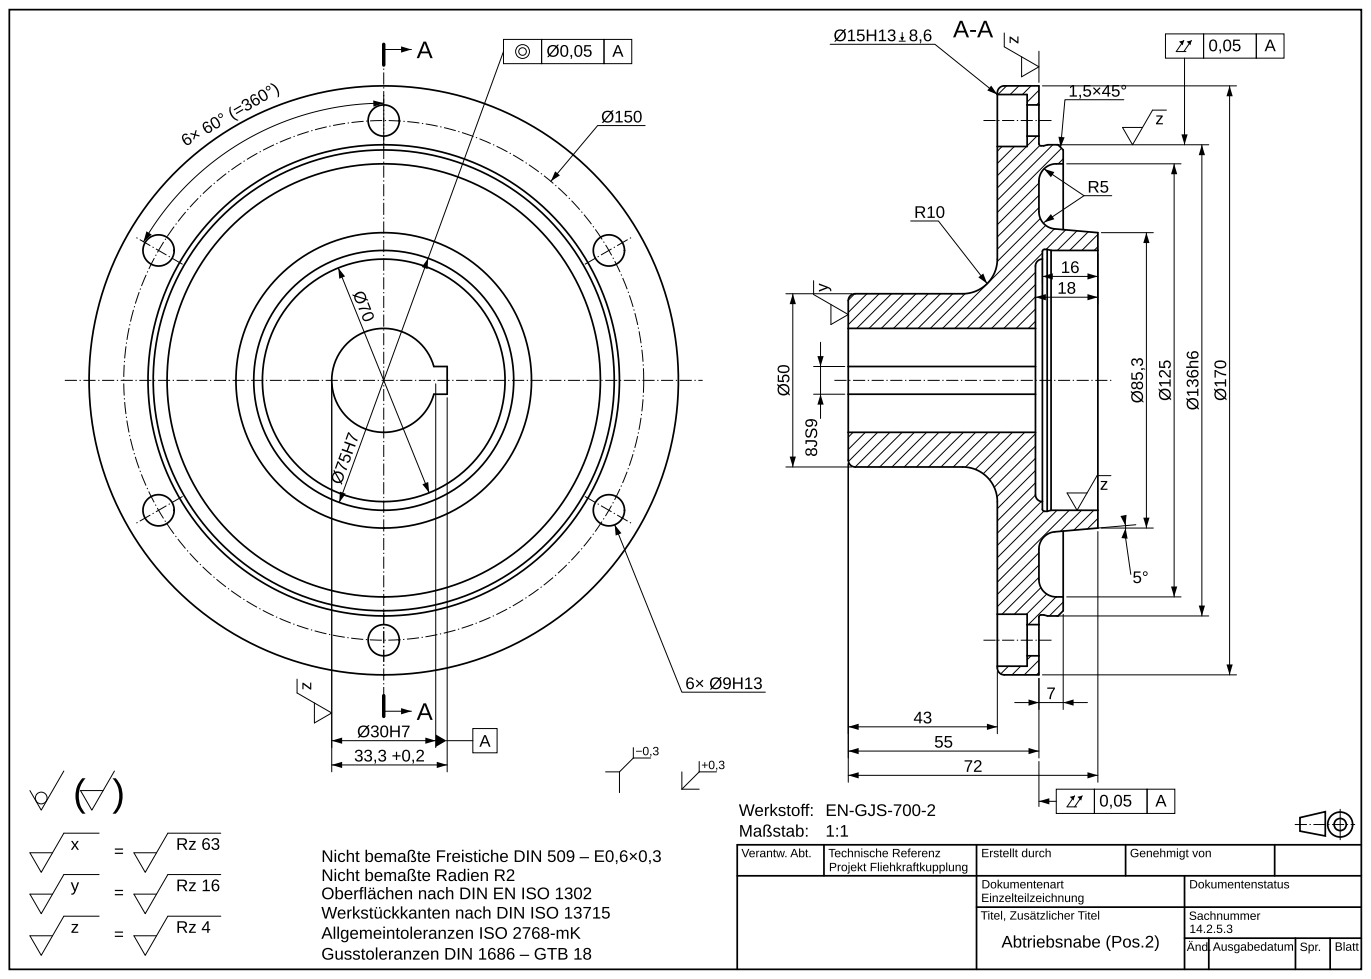
[picture p134: page 2]
Verantw. Abt.; Technische Referenz; Projekt Fliehkraftkupplung; Erstellt durch; Genehmigt von; Dokumentenstatus; Sachnummer; Änd.Ausgabedatum; Spr.; Blatt

Werkstoff: EN-GJS-700-2
Maßstab: 1:1

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

Dokumentenart
Einzelteilzeichnung
Titel, Zusätzlicher Titel
Abtriebsnabe (Pos.2)

70⁺⁰,2

0,05 B | 0,05 A

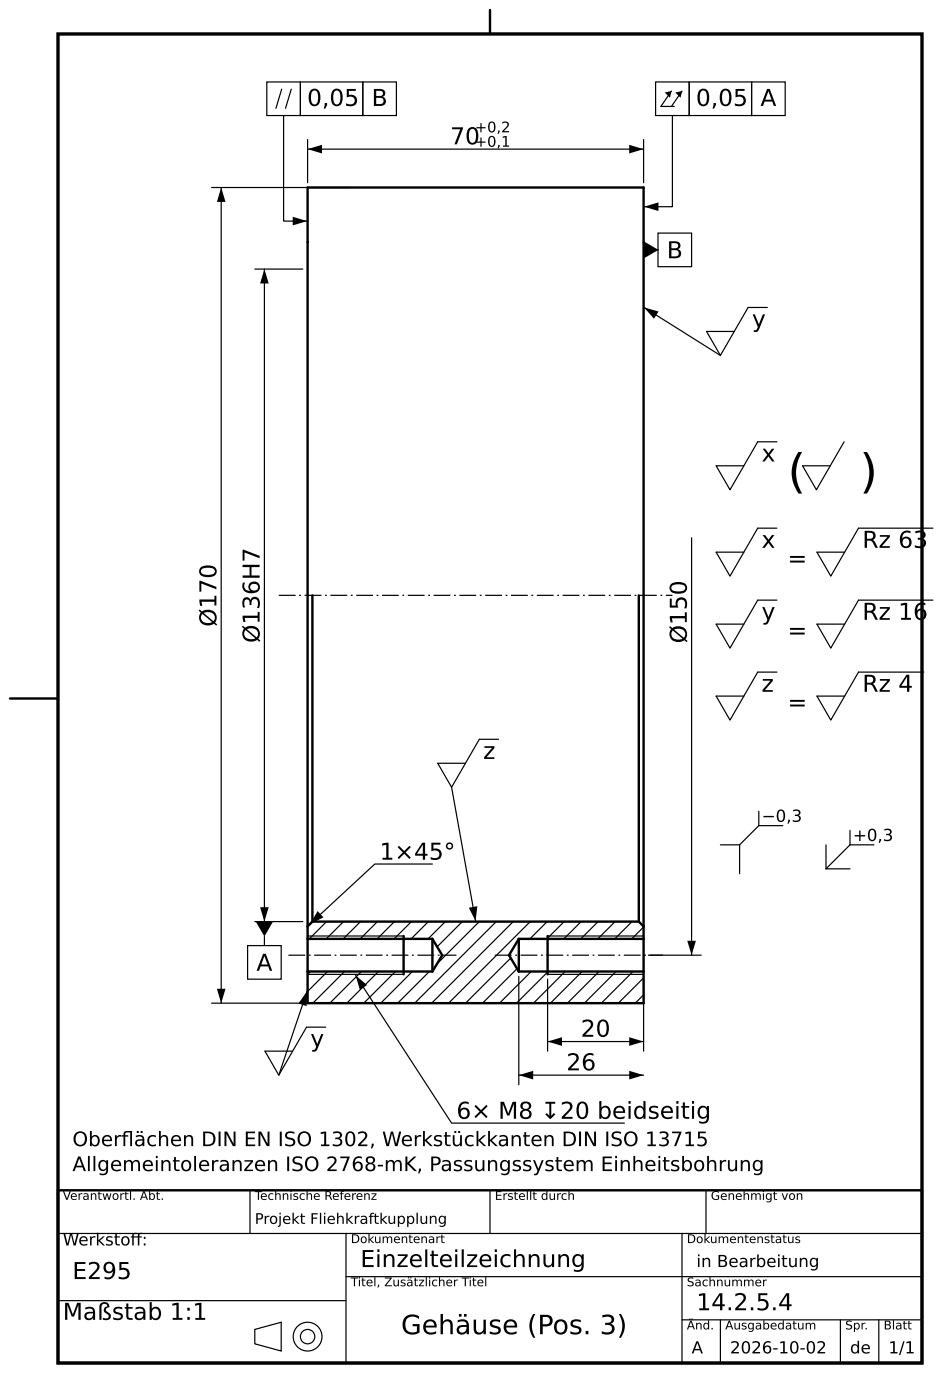
[picture p135: page 3]
6× M8 ↧20 beidseitig; Verantwortl. Abt.; Technische Referenz; Erstellt durch; Genehmigt von; Projekt Fliehkraftkupplung; Dokumentenart Einzelteilzeichnung; Dokumentenstatus in Bearbeitung; Sachnummer; Änd.; Ausgabedatum; Spr.; Blatt; Werkstoff:; Maßstab 1:1

Oberflächen DIN EN ISO 1302, Werkstückkanten DIN ISO 13715
Allgemeintoleranzen ISO 2768-mK, Passungssystem Einheitsbohrung

Titel, Zusätzlicher Titel
Gehäuse (Pos. 3)

A

# A–A Ø¹⁷⁰

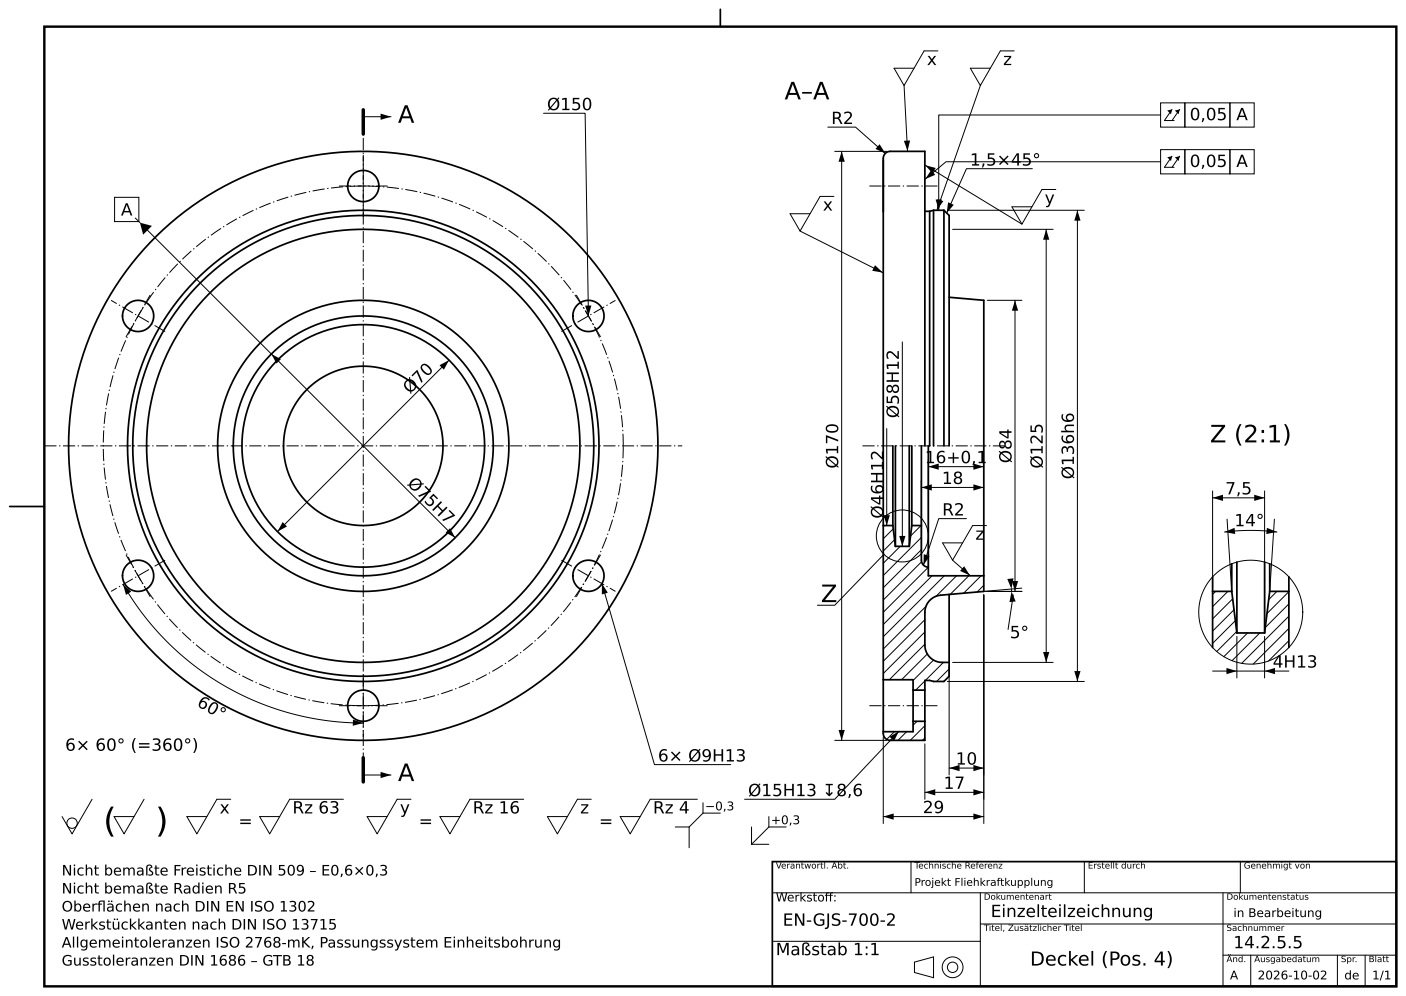
[picture p136: page 4]
Nicht bemaßte Freistiche DIN 509 – E0,6×0,3; Verantwortl. Abt.; Technische Referenz; Erstellt durch; Genehmigt von; Projekt Fliehkraftkupplung; Dokumentenart Einzelteilzeichnung; Dokumentenstatus in Bearbeitung; Sachnummer; Werkstoff:; EN-GJS-700-2; Maßstab 1:1

Nicht bemaßte Radien R5
Oberflächen nach DIN EN ISO 1302
Werkstückkanten nach DIN ISO 13715
Allgemeintoleranzen ISO 2768-mK, Passungssystem Einheitsbohrung

Titel, Zusätzlicher Titel
Deckel (Pos. 4)

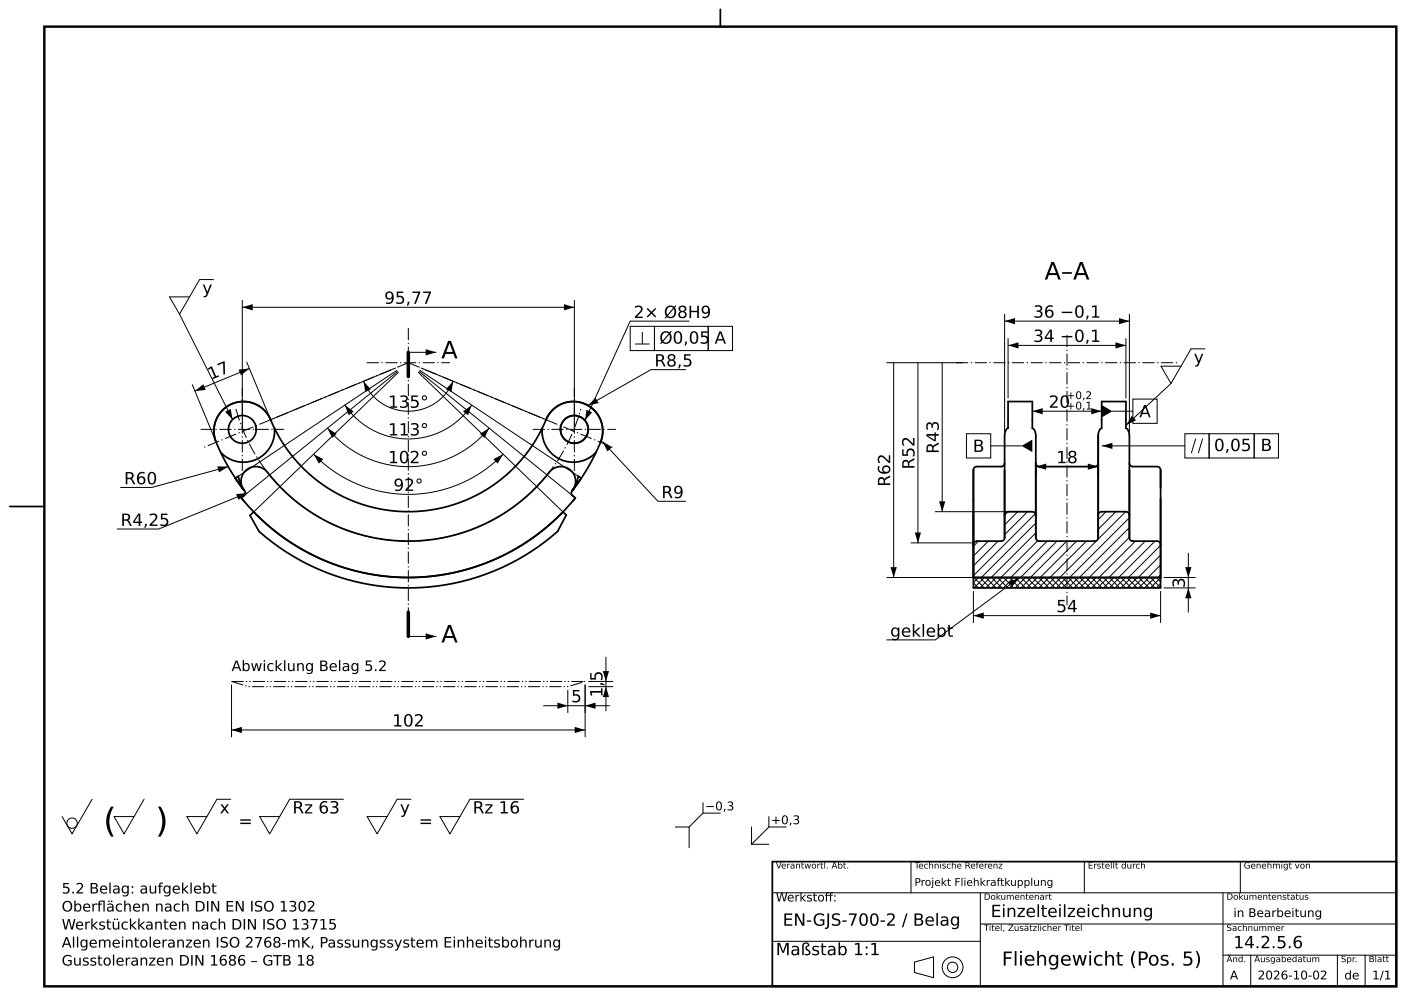
[picture p137: page 5]
Abwicklung Belag 5.2; geklebt; Verantwortl. Abt.; Technische Referenz; Erstellt durch; Genehmigt von; Projekt Fliehkraftkupplung; Dokumentenart Einzelteilzeichnung; Dokumentenstatus in Bearbeitung; Sachnummer

5.2 Belag: aufgeklebt
Oberflächen nach DIN EN ISO 1302
Werkstückkanten nach DIN ISO 13715
Allgemeintoleranzen ISO 2768-mK, Passungssystem Einheitsbohrung

Werkstoff:
EN-GJS-700-2 / Belag
Maßstab 1:1

Titel, Zusätzlicher Titel
Fliehgewicht (Pos. 5)

1,5 −0,1 Ø⁹

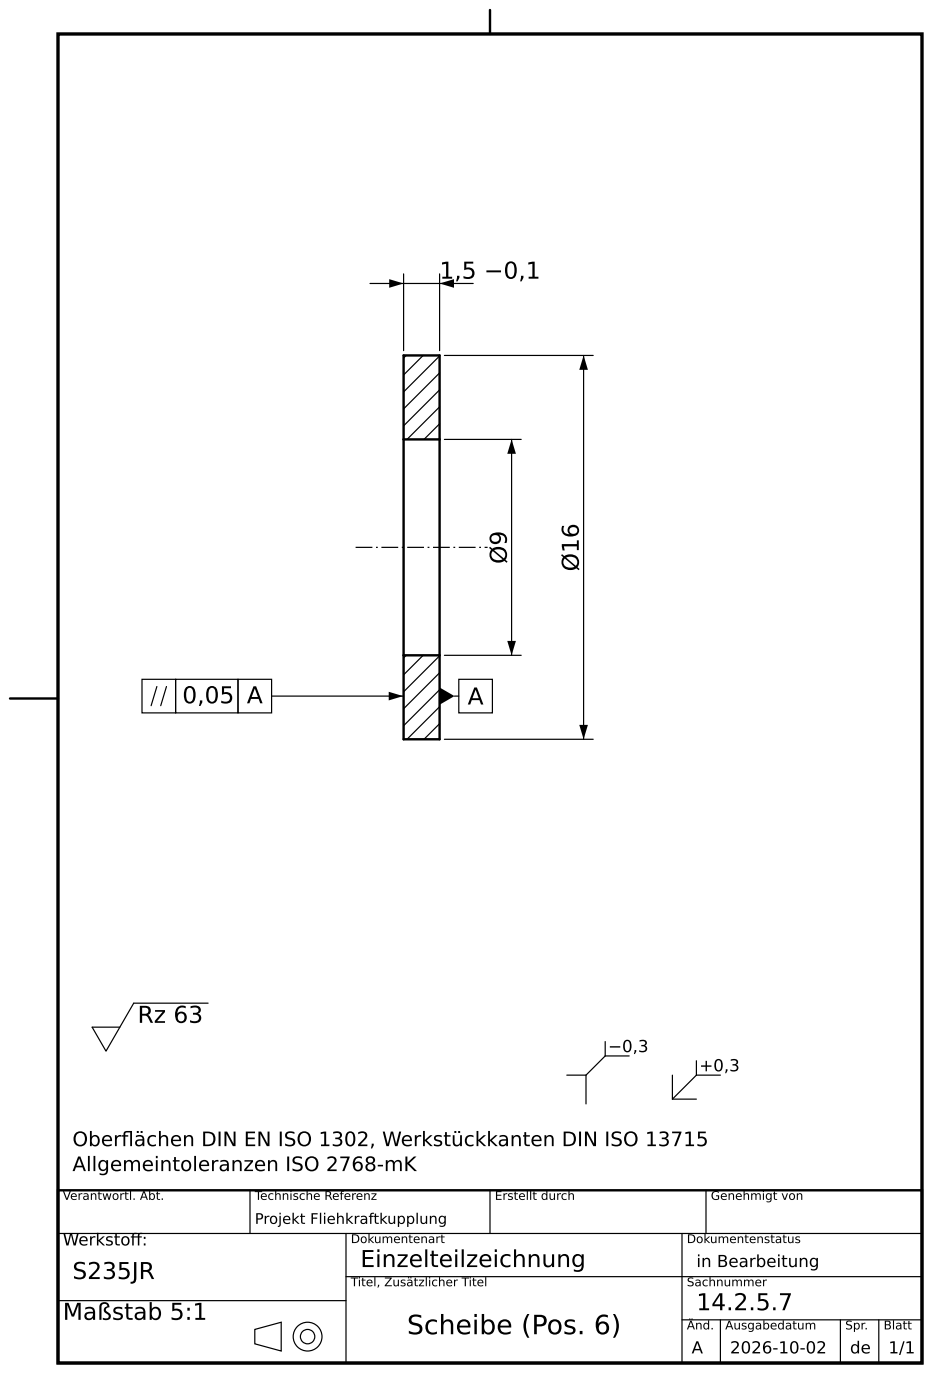
[picture p138: page 6]
Verantwortl. Abt.; Technische Referenz; Erstellt durch; Genehmigt von; Projekt Fliehkraftkupplung; Dokumentenart Einzelteilzeichnung; Dokumentenstatus in Bearbeitung; Sachnummer; Werkstoff:; Maßstab 5:1

Oberflächen DIN EN ISO 1302, Werkstückkanten DIN ISO 13715
Allgemeintoleranzen ISO 2768-mK

Titel, Zusätzlicher Titel
Scheibe (Pos. 6)

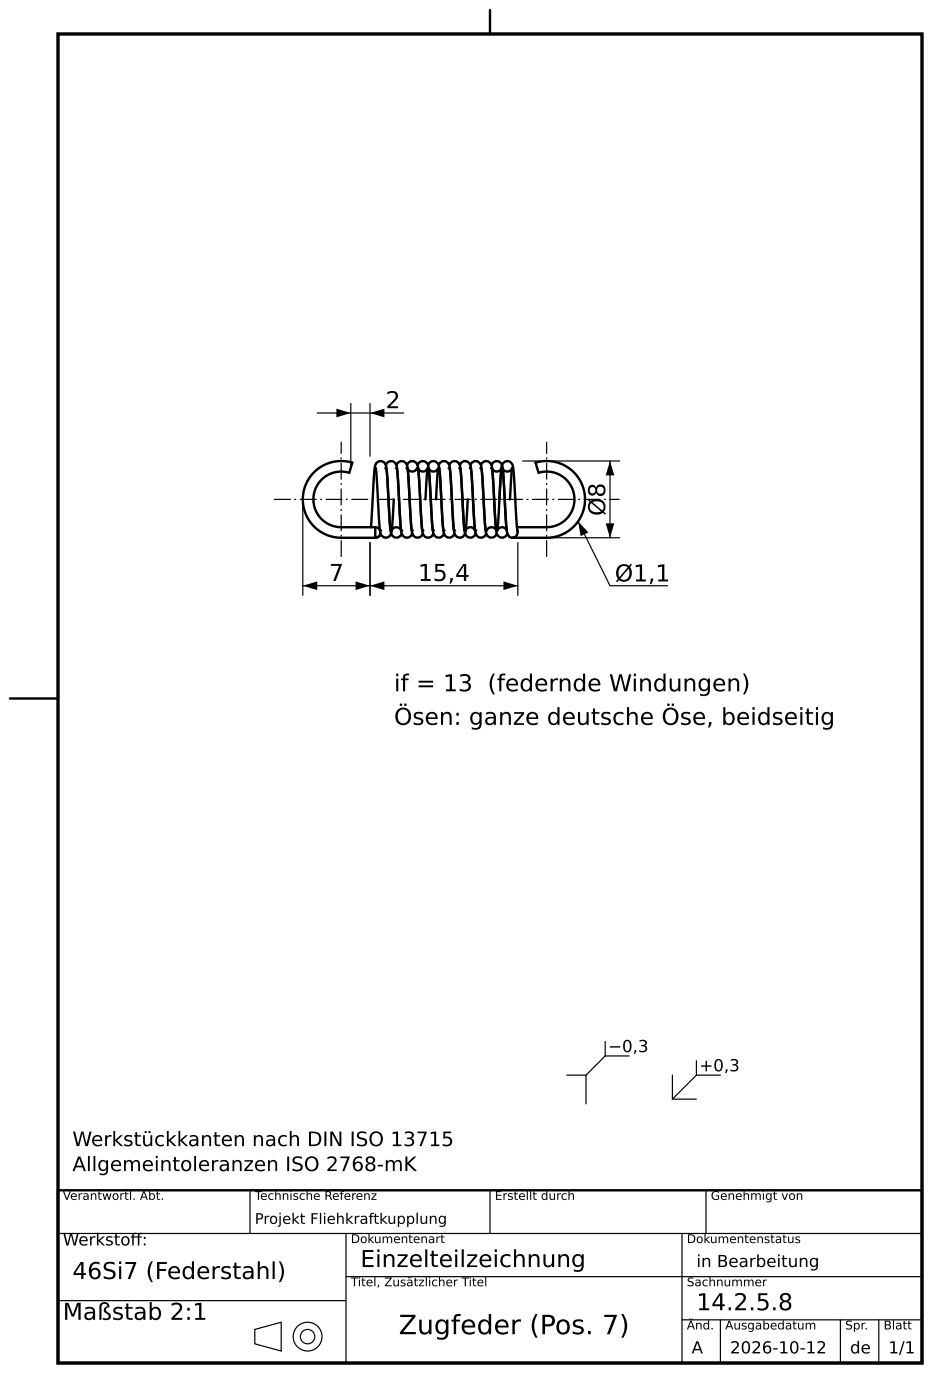
[picture p139: page 7]
Verantwortl. Abt.; Technische Referenz; Erstellt durch; Genehmigt von; Projekt Fliehkraftkupplung; Dokumentenart Einzelteilzeichnung; Dokumentenstatus in Bearbeitung; Sachnummer; Werkstoff:; 46Si7 (Federstahl); Maßstab 2:1

if = 13 (federnde Windungen)
Ösen: ganze deutsche Öse, beidseitig

Werkstückkanten nach DIN ISO 13715
Allgemeintoleranzen ISO 2768-mK

Titel, Zusätzlicher Titel
Zugfeder (Pos. 7)

45,2

(50)

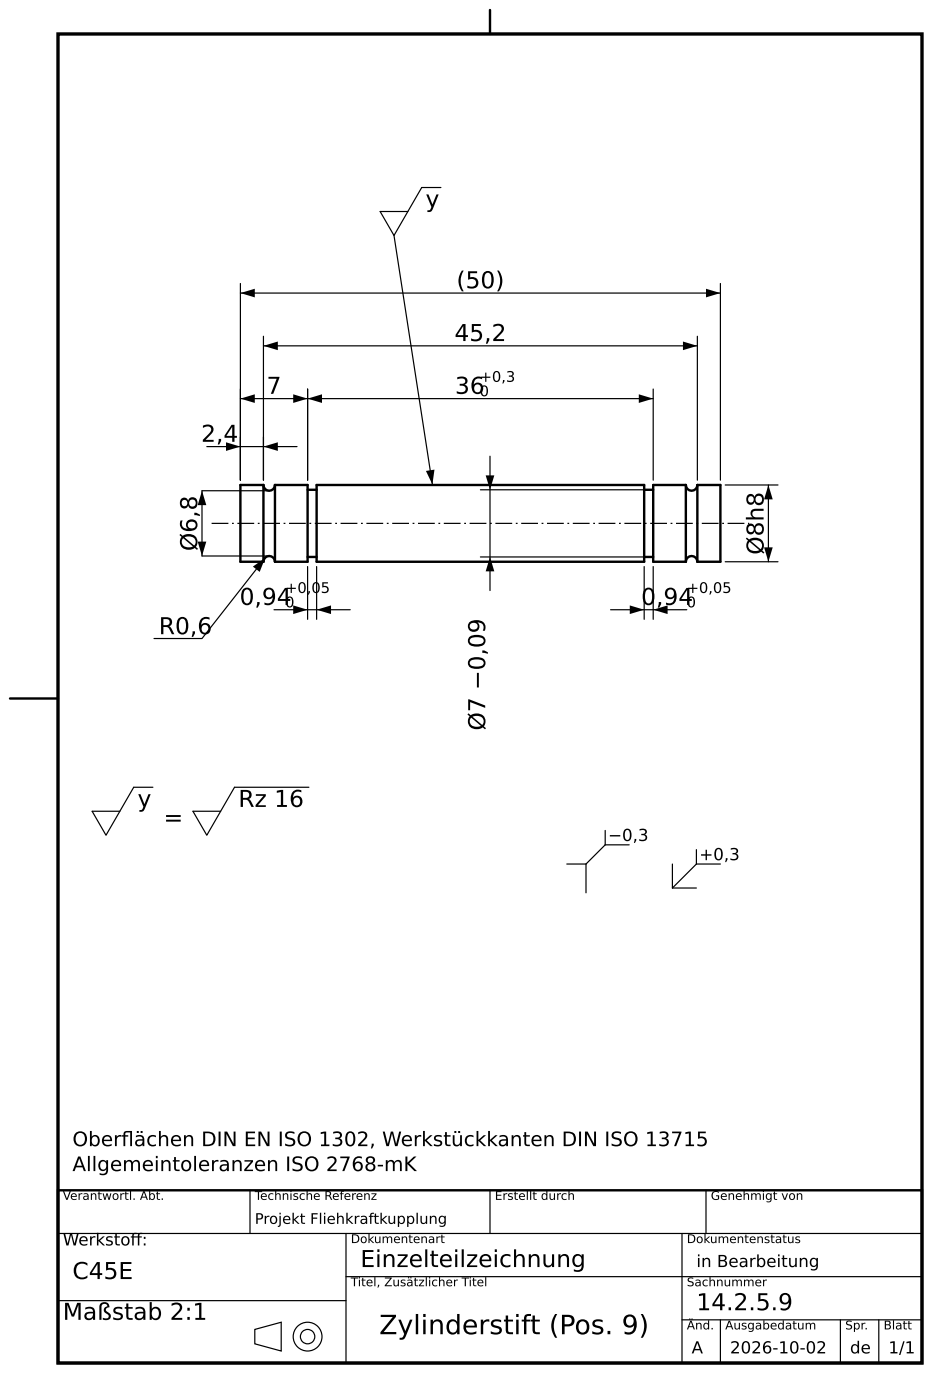
[picture p140: page 8]
Verantwortl. Abt.; Technische Referenz; Erstellt durch; Genehmigt von; Projekt Fliehkraftkupplung; Dokumentenart Einzelteilzeichnung; Dokumentenstatus in Bearbeitung; Sachnummer; Werkstoff:; Maßstab 2:1

Oberflächen DIN EN ISO 1302, Werkstückkanten DIN ISO 13715
Allgemeintoleranzen ISO 2768-mK

Titel, Zusätzlicher Titel
Zylinderstift (Pos. 9)
