thomaswach7/KOP/Teil_A/Gesamtzeichnung_Fliehkraftkupplung.pdf

A
A-A

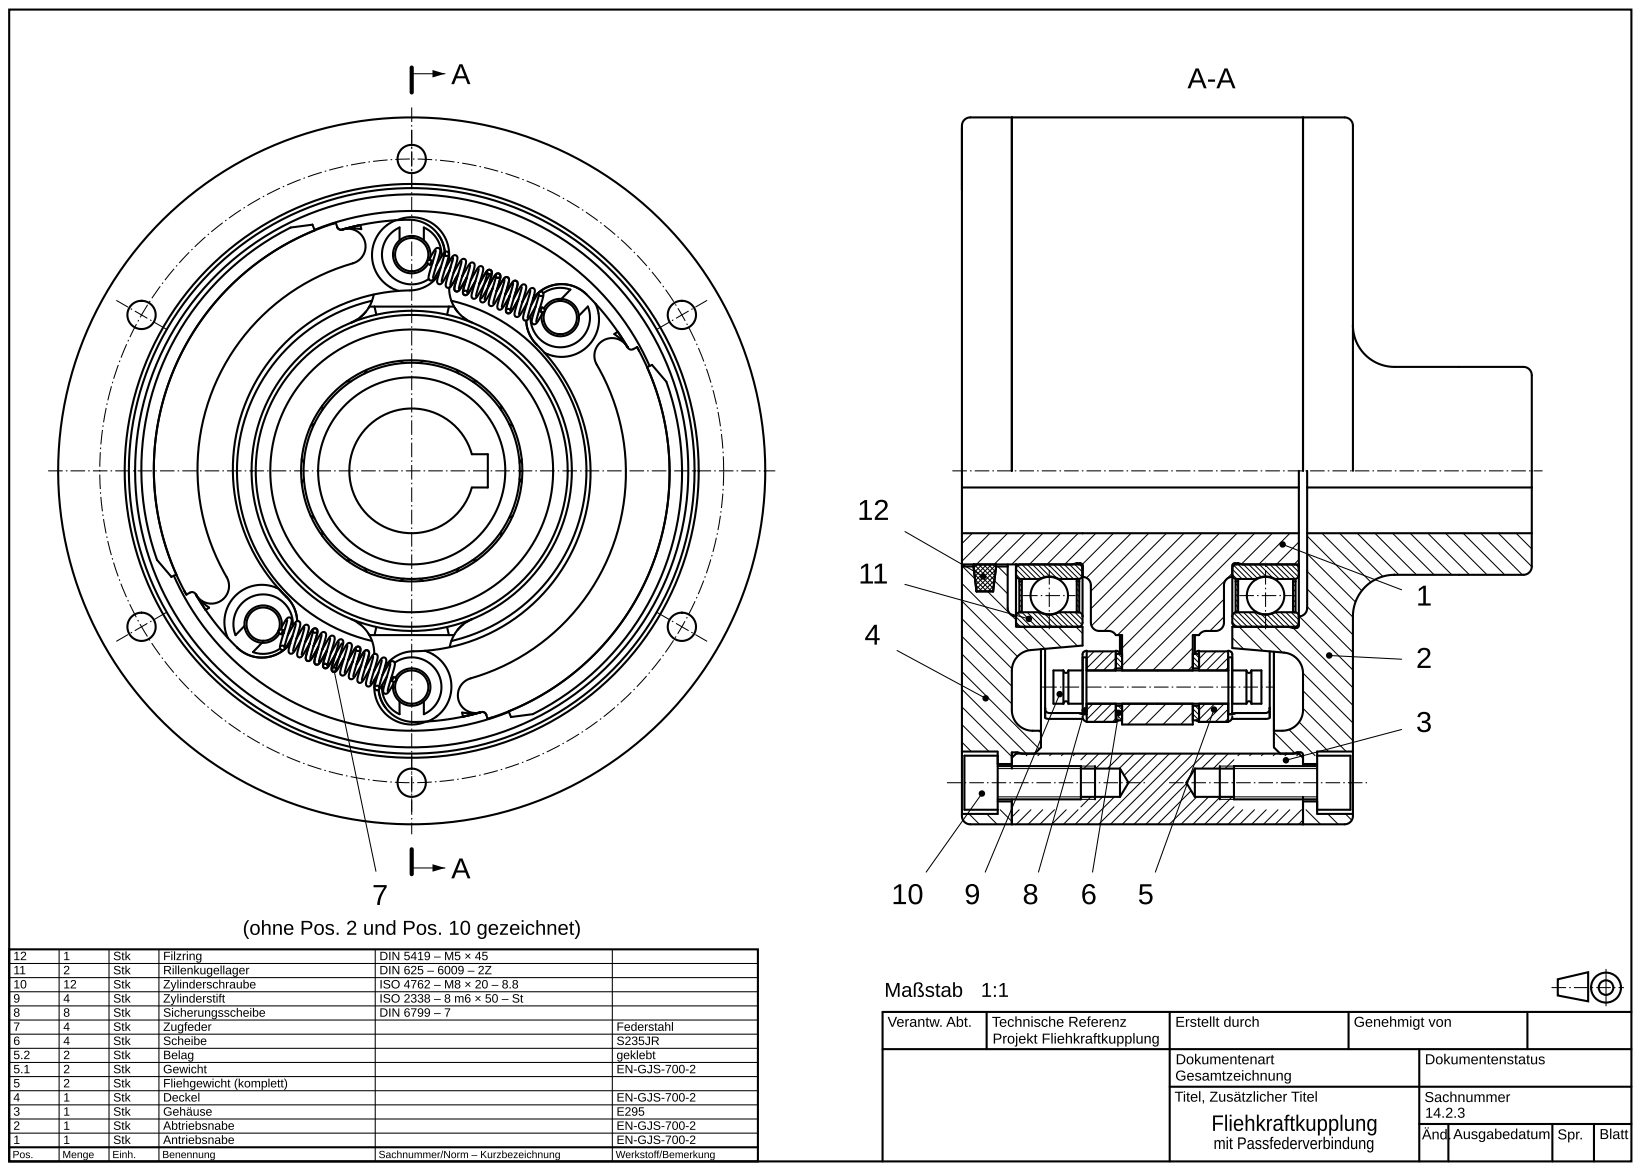
[picture p141: page 1]
Pos.; Menge; Einh.; Benennung; Sachnummer/Norm – Kurzbezeichnung; Werkstoff/Bemerkung; Stk; Antriebsnabe; EN-GJS-700-2; Abtriebsnabe; Gehäuse; Deckel; Fliehgewicht (komplett); Gewicht; Belag; geklebt; Scheibe; Zugfeder; Federstahl; Sicherungsscheibe; DIN 6799 – 7; Zylinderstift; ISO 2338 – 8 m6 × 50 – St; Zylinderschraube; ISO 4762 – M8 × 20 – 8.8; Rillenkugellager; DIN 625 – 6009 – 2Z; Filzring; DIN 5419 – M5 × 45; Verantw. Abt.; Technische Referenz; Projekt Fliehkraftkupplung; Erstellt durch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

(ohne Pos. 2 und Pos. 10 gezeichnet)

Dokumentenart
Gesamtzeichnung
Titel, Zusätzlicher Titel
