thomaswach7/KOP/Teil_A/Gesamtzeichnung_Fliehkraftkupplung_wie_Vorlage.pdf

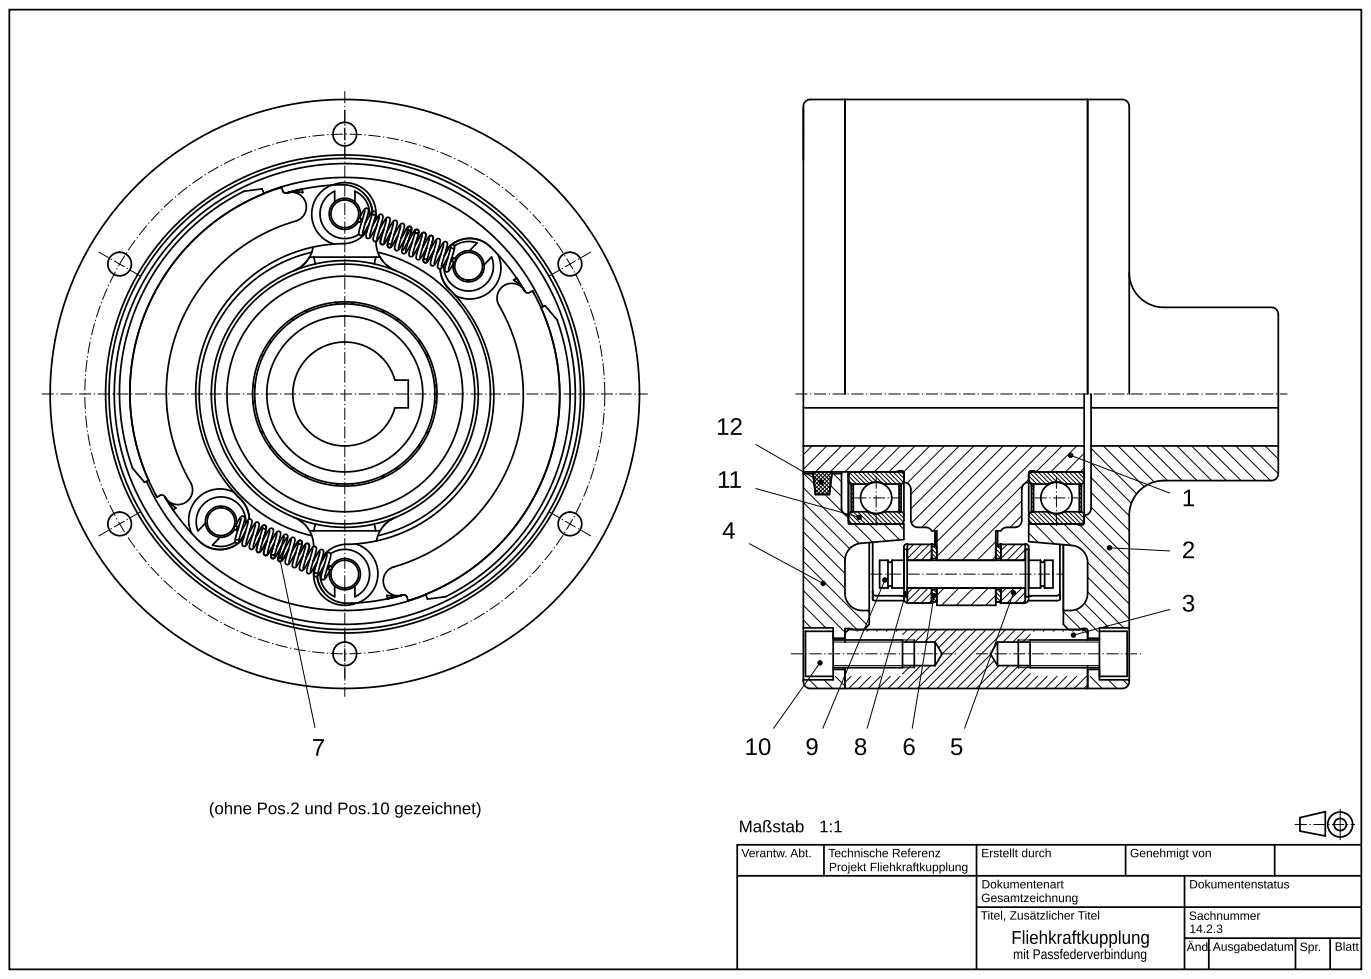
[picture p142: page 1]
Verantw. Abt.; Technische Referenz; Projekt Fliehkraftkupplung; Erstellt durch; Genehmigt von; Dokumentenstatus; Sachnummer 14.2.3; Änd.Ausgabedatum; Spr.; Blatt; Maßstab 1:1

(ohne Pos.2 und Pos.10 gezeichnet)

Dokumentenart
Gesamtzeichnung
Titel, Zusätzlicher Titel
