thomaswach7/KOP/Teil_D/Pos07_Zugfeder.pdf

Verantwortl. Abt.; Technische Referenz; Erstellt durch; Genehmigt von; Projekt Fliehkraftkupplung; Dokumentenart Einzelteilzeichnung; Dokumentenstatus in Bearbeitung; Sachnummer 14.2.5.8; Änd.; Ausgabedatum; Spr.; Blatt; Werkstoff:; 46Si7 (Federstahl); Maßstab 2:1

if = 13 (federnde Windungen)
Ösen: ganze deutsche Öse, beidseitig

Werkstückkanten nach DIN ISO 13715
Allgemeintoleranzen ISO 2768-mK

Titel, Zusätzlicher Titel
Zugfeder (Pos. 7)
