thomaswach7/KOP/Teil_D/Pos04_Deckel.pdf

A

# A–A Ø¹⁷⁰

Nicht bemaßte Freistiche DIN 509 – E0,6×0,3; Verantwortl. Abt.; Technische Referenz; Erstellt durch; Genehmigt von; Projekt Fliehkraftkupplung; Dokumentenart Einzelteilzeichnung; Dokumentenstatus in Bearbeitung; Sachnummer 14.2.5.5; Änd.; Ausgabedatum; Spr.; Blatt; Werkstoff:; EN-GJS-700-2; Maßstab 1:1

Nicht bemaßte Radien R5
Oberflächen nach DIN EN ISO 1302
Werkstückkanten nach DIN ISO 13715
Allgemeintoleranzen ISO 2768-mK, Passungssystem Einheitsbohrung
Gusstoleranzen DIN 1686 – GTB 18

Titel, Zusätzlicher Titel
Deckel (Pos. 4)
