thomaswach7/KOP/Teil_D/Pos05_Fliehgewicht.pdf

Abwicklung Belag 5.2; geklebt; Verantwortl. Abt.; Technische Referenz; Erstellt durch; Genehmigt von; Projekt Fliehkraftkupplung; Dokumentenart Einzelteilzeichnung; Dokumentenstatus in Bearbeitung; Sachnummer 14.2.5.6; Änd.; Ausgabedatum; Spr.; Blatt

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

Werkstoff:
EN-GJS-700-2 / Belag
Maßstab 1:1

Titel, Zusätzlicher Titel
Fliehgewicht (Pos. 5)
