thomaswach7/KOP/Teil_D/Pos06_Scheibe.pdf

1,5 −0,1 Ø⁹

Verantwortl. Abt.; Technische Referenz; Erstellt durch; Genehmigt von; Projekt Fliehkraftkupplung; Dokumentenart Einzelteilzeichnung; Dokumentenstatus in Bearbeitung; Sachnummer 14.2.5.7; Änd.; Ausgabedatum; Spr.; Blatt; Werkstoff:; Maßstab 5:1

Oberflächen DIN EN ISO 1302, Werkstückkanten DIN ISO 13715
Allgemeintoleranzen ISO 2768-mK

Titel, Zusätzlicher Titel
Scheibe (Pos. 6)
