thomaswach7/KOP/Teil_D/Pos09_Zylinderstift.pdf

45,2

(50)

Verantwortl. Abt.; Technische Referenz; Erstellt durch; Genehmigt von; Projekt Fliehkraftkupplung; Dokumentenart Einzelteilzeichnung; Dokumentenstatus in Bearbeitung; Sachnummer 14.2.5.9; Änd.; Ausgabedatum; Spr.; Blatt; Werkstoff:; Maßstab 2:1

Oberflächen DIN EN ISO 1302, Werkstückkanten DIN ISO 13715
Allgemeintoleranzen ISO 2768-mK

Titel, Zusätzlicher Titel
Zylinderstift (Pos. 9)
