thomaswach7/KOP/(commit log)

2026-10-02 Teil B Frage 1: Rillenkugellager 6009-2Z erklärt und begründet
    Claude-Session: https://claude.ai/code/session_01DUyfD7BnkN5u3RbVtcLrRk
2026-10-02 Teil A: Baugruppe und Gesamtzeichnung Fliehkraftkupplung, Stand Pos. 1-8
    - STEP-Baugruppe Pos. 1-8 (kollisionsgeprüft), fehlende Teile Pos. 3/6/7(gespannt)/8 nachmodelliert
    - Gesamtzeichnung A3 1:1: Schnitt A-A, Vorderansicht ohne Pos. 2, Stückliste, Schriftfeld
    - README mit Einbaumaßen/Abhängigkeiten und Hinweisen auf Fehler in den Unterlagen
    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
    [Baugruppe_Fliehkraftkupplung_Pos1-8.step, Pos03_Gehaeuse.step, Pos06_Scheibe_16x9x1,5.step, Pos07_Zugfeder_gespannt.step, Pos08_Sicherungsscheibe_DIN6799-7.step]
2026-10-02 Teil D: Einzelteilzeichnungen Pos. 1-5 bemaßt
    - Antriebsnabe, Abtriebsnabe (neu, fehlte im Datensatz), Gehäuse, Deckel, Fliehgewicht
    - Passungen, Oberflächen (Rz), Form- und Lagetoleranzen laut Angabe Teil D
    - README mit Toleranzübersicht und gefundenen Abweichungen Buch/Modell
    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
2026-10-05 Teil A: komplette Baugruppe Pos. 1-12 mit dokumentiertem Montageablauf
    - Pos. 9-12 ergänzt (Zylinderstifte, Zylinderschrauben, Rillenkugellager, Filzring)
    - Kollisionsprüfung aller 903 Teilepaare, gefundene Überschneidungen behoben
    - Montageablauf in 12 Schritten mit 3D-Bildern (PDF + README)
    - Gesamtzeichnung auf alle 12 Positionen aktualisiert, Stückliste vollständig
    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
    [Baugruppe_Fliehkraftkupplung_Pos1-8.step, Baugruppe_Fliehkraftkupplung_komplett.step, Pos09_Zylinderstift_8x50.step, Pos10_Zylinderschraube_ISO4762_M8x20.step, Pos11_Rillenkugellager_6009-2Z_vereinfacht.step, Pos12_Filzring_DIN5419_45.step]
2026-10-05 Teil A: alle Einzelteile als STEP (Pos. 1-12) in einem Ordner und als ZIP
    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
    [Pos01_Antriebsnabe.stp, Pos02_Abtriebsnabe.stp, Pos03_Gehaeuse.stp, Pos04_Deckel.stp, Pos05-1_Gewicht.stp, Pos05-2_Belag.stp, Pos05_Fliehgewicht_komplett.stp, Pos06_Scheibe.stp]
2026-10-05 Modellbaum-Skizzen: R2 als echtes Radiusmass, zweites Ø51 an der Antriebsnabe ergaenzt
    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
2026-10-05 Modellbaum: Freistiche DIN 509-E0,6x0,3 an Pos. 1, 2, 4 ergaenzt, eigene Freistich-Seite, Kontroll-STEP
    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
    [Pos01_Antriebsnabe.step, Pos02_Abtriebsnabe.step, Pos03_Gehaeuse.step, Pos04_Deckel.step, Pos05-1_Gewicht.step, Pos05-2_Belag.step, Pos06_Scheibe.step, Pos07_Zugfeder_ungespannt.step]
2026-10-09 Antriebsnabe: Zeichnung mit Freistichen im Schnitt A-A, zusaetzlich als DXF fuer Creo
    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
    [Pos01_Antriebsnabe.dxf]
2026-10-09 Antriebsnabe: Zeichnung nach Vorlage 14.2.5.2 neu (Halbschnitt A-A, Nut links, Mass 79 zwischen Fussflaechen), PDF + DXF
    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
    [Pos01_Antriebsnabe.dxf]
2026-10-09 Antriebsnabe: Schriftfeld, Schrift (Arial/Liberation Sans) und Hinweisblock 1:1 nach Vorlage 14.2.5.2
    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
    [Pos01_Antriebsnabe.dxf]
2026-10-09 Antriebsnabe DXF: Mittellinien schwarz statt rot
    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
    [Pos01_Antriebsnabe.dxf]
2026-10-09 Portrait_CAD: DXF-Linienzeichnung und STL-Relief aus Portraitfoto fuer Creo-Import
    Claude-Session: https://claude.ai/code/session_01748yeiXPzgpVUNkxHbW7o6
    [portrait_linien.dxf, portrait_relief.stl]
2026-10-09 Skulptur_3D: 3D-Kopfbueste (STL) aus 360-Grad-Video per SfM + Visual Hull, inkl. Skripte und Vorschau
    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
    [kopf_skulptur.stl]
2026-10-28 Gesamtzeichnung geprüft und korrigiert; DXF 1:1 wie PDF (Text als Geometrie)
    - Lagerkugeln waren Halbkugeln (CadQuery-Standard) -> Vollkugeln; Lagerringe mit Kantenradius r = 1
    - Schraffur Deckel (4) gegenläufig zur Antriebsnabe (1), Hinweispunkt Pos. 8 auf der Sicherungsscheibe
    - unsichtbare Kantenstücke in Schnittflächen entfernt, Lager vereinfacht wie Vorlage
    - Titel/Untertitel im Schriftfeld wie Vorlage gesetzt
    - DXF: Texte als Geometrie, Strich-Punkt-Linien als Striche (dxfout_geo.py)
    - STEP-Baugruppe und Pos. 11 neu exportiert, Abtriebsnabe-Nut fluchtend, Kollisionsprüfung dokumentiert
    Claude-Session: https://claude.ai/code/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
2026-11-06 Abtriebsnabe (Pos. 2): Einzelteilzeichnung A3 1:1 im Stil 14.2.5.2, PDF + DXF
    Vorderansicht und Schnitt A-A durch zwei Bohrungen. Masse aus dem STEP-Modell
    geprueft, Toleranzen nach Angabe Teil D (Bezug A = Achse 30H7). Sammel-PDF und
    README ergaenzt.
    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
